Suturin-Daniil/Shchegly_SKAT26/Аэродинамика/Статистика/SpyLite.jpg

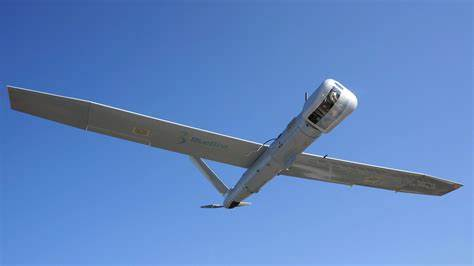
Аэродинамика/Статистика/SpyLite.jpg
