Suturin-Daniil/Shchegly_SKAT26/Аэродинамика/Статистика/Albatross.jpg

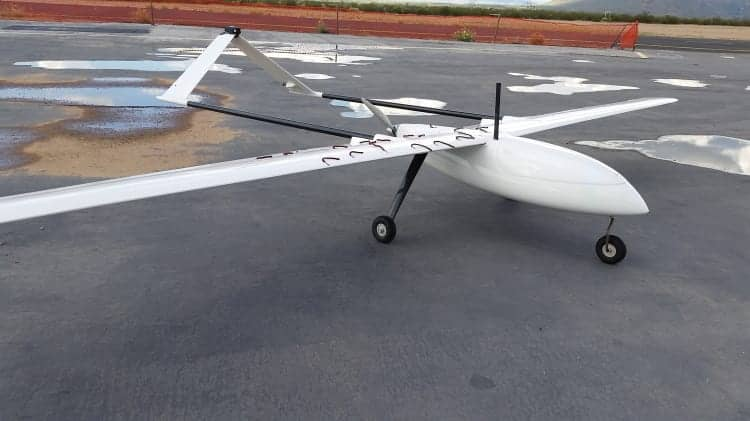
Аэродинамика/Статистика/Albatross.jpg
