Suturin-Daniil/Shchegly_SKAT26/БортовоеОборудование/USB_TTL.pdf

### USB to TTL, with embedded convertor

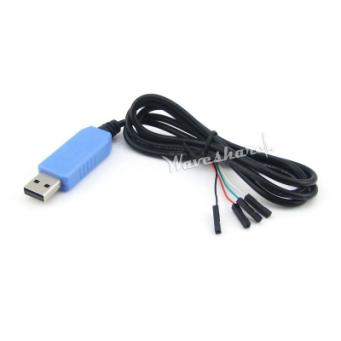
[picture p4: figure]

## Overview

USB to TTL 4-pin Wire specification:

- Embedded convertor: PL2303
- Supports Win8
- Connector: USB Type-A plug, 4-pin 2.54mm jumper wire connectors
- Jumper wire pinout:
- Red - VCC
- Black - GND
- Green - TXD
- White - RXD
- Length: 1m
