Suturin-Daniil/Shchegly_SKAT26/КомпьютерноеЗрение/dataset/readme.txt

Датасет из букв армянского алфавита.
200px — папка с исходными буквами размером 200х200.
Остальные размеры получаются путем ресайза с помощью python скрипта.
Все изображения следует сохранять в черно-белом варианте (8 бит на пиксель).
