Suturin-Daniil/Shchegly_SKAT26/Аэродинамика/ВыборПрофиля/ВыборПрофиляКрылаХвоста.docx

# 1 Облик ЛА

# Крыло и хвостовое оперений

В ходе анализа скоростного режима ЛА при выполнении полетного задания были определены воздушная скорость V_a = 18 м/с и диапазон чисел Рейнольдса, соответствующий скоростному режиму и геометрическим характеристикам БВС, Re≈(1÷5)⋅10^5 . Такой характер обтекания предполагает использования специализированных профилей, спроектированных для малых чисел Рейнольдса.

Первоначальную оценку коэффициент подъемной силы всего БВС C_(L_C) можно выполнить, зафиксировав вес снаряженного БВС W≈34,3 Н :

| C_(L_C) =(2L)/(ρV_a^2 S)= (2W)/(ρV_a^2 S) | (1)

Согласно статистике [2] C_(L_C) находится в диапазоне 0,4÷0,7. Выбирать целевой C_(L_C) следует на основе существующих профилей и геометрии крыла, обеспечивающих требуемый C_(L_C) . Завысим C_(L_C) – рискуем проиграть в общем сопротивлении БВС за счет индуцированного; занизим – рискуем получить крупное крыло, которое вносит существенный вклад в паразитное сопротивление. Для начальной оценки выберем C_(L_C) =0,45 , обоснование чего будет явным в последующих частях отчета. Таким образом, оценим согласно (1) требуемую площадь крыла S ; после подстановки получим S≈0,38 м^2 .

Сужение крыла λ зафиксируем равным 1 , прямое крыло. Удлинение AR=8 согласно статистическим данным из [3]. Угол установки крыла i_w был получен из оценки общего коэффициента подъемной силы БВС, который соответствует требуемому C_(L_C) при i_w =1° . Геометрические характеристики крыла представлены в таблице 1.

AR | λ | b, м | c, м | S, м^2 | i_w , °
8 | 1 | 1,74 | 0,22 | 0,38 | 1

Таблица 1 – Геометрические характеристики крыла

Выбор параметров хвостового оперения основан на методе объемных коэффициентов (2). Согласно данным из [3] и опыта команды объемные коэффициенты вертикального V_(VT) и горизонтального V_(HT) оперений выбраны равными 0,04 и 0,6 соответсвтенно.

| V_(HT) = (L_T S_(HT))/(cS), V_(VT) =(L_T S_(VT))/(bS), | (2)

где плечи горизонтального и вертикального оперения L_T (расстояние от аэродинамических центров хвостового оперения и крыла) выбраны равными, так как V-образный хвост. Согласно [4] площадь V-образного хвоста S_T есть сумма площадей вертикальной S_(VT) и горизонтальной S_(HT) составляющих, а угол V-образности Γ выражается следующим образом:

| S_T ≈S_(VT) +S_(HT) , Γ=arctan((S_(VT))/(S_(HT))) | (3)

Таким образом, геометрические характеристики одной консоли V-образного оперения представлены в таблице 2 ниже

AR_T | λ_T | b_T , м | c_T , м | S_T , м^2 | Γ,° | i_T , °
2 | 0,60 | 0,29 | 0,15 | 0,085 | 28 | 0,5

Таблица 2 – Геометрические характеристики хвостового оперения (одной консоли)

Угол установки хвостового оперения i_T был определен из требований продольной устойчивости, что будет показано в разделе продольная устойчивость.

# Управляющие поверхности

Размер управляющих поверхностей и доля размаха хвостового оперения и крыла, занимаемого ими, указаны в таблице 3.

| Элероны/Закрылки | Руль высоты
Доля хорды ( c_f /c ) | 0,3 | 0,3
Доля размаха ( b_f /b ) | 0,5 | 0,9

Таблица 3 – Геометрические характеристики управляющих поверхностейт имас

Выбор такой геометрии обусловлен тем, что предельная эффективность управляющих поверхностей (максимальный прирост ΔC_L за счет отклонения рулей) (рисунок 2) достигается при небольших углах отклонения рулей до 15°÷20° . Более того, как будет показано далее, такая конфигурация обеспечивает статическую устойчивость в продольном канале БВС.

# Аэродинамические профили

Исследуя материалы [1], был выбран ряд аэродинамических профилей для крыла, спроектированных для Проведен сравнительный анализ на основе критериев для различных этапов полета. Результат представлен ниже в таблице 1

Критерии | | | SD7032 | SD7037 | SG6041 | SG6043
Целевой C_(L_(max)) | | | 1,35
C_L для круиза | | | 0,48
Относительная толщина | | | 0,10 | 0,09 | 0,10 | 0,09
сваливание | Re | | 150'000
| C_l (0) (ближе к C_(L_c) – лучше) | | 0,44 | 0,37 | 0,24 | 0,51
| α_(ZL) , C_l (α_(ZL) )=0 | | -3,20° | -2,30° | -0,95° | -3,39°
| C_(l_(max)) | | 1,41 | 1,30 | 1,20 | 1,60
| α_s , C_l (α_s )=C_(l_(max)) | | 12,90° | 12,40° | 11,20° | 15,30°
| Характер сваливания | | Пологий | Крутой | Крутой | Крутой
круиз | Re | | 300'000
| C_(d_(min)) | | 0,0073 | 0,0070 | 0,0080 | 0,0093
| Чувствительность к качеству поверхности | | - | - | + | +
| C_l (C_(d_(min)) ) (ближе к C_(L_c) – лучше) | | 0,40 | 0,42 | 0,59 | 0,81
| ((C_l)/(C_d))_(max) | | 90 | 85 | 85 | 117
| C_l для ((C_l)/(C_d))_(max) (меньше – лучше) | | 0,98 | 0,85 | 0,69 | 1,20
| C_m для круиза (меньше |C_m | – лучше) | | -0,09 | -0,08 | -0,06 | -0,17
подъем | Re | | 200'000
| Laminar drag bucket | Начинается с C_l | 0,20 | 0,13 | -0,12 | 0,55
| | Кончается с C_l | 1,00 | 0,80 | 0,70 | 1,20
| C_(L_c) внутри | | + | + | + | -

Таблица 4 – Сравнительная характеристика профилей для крыла

1. Lyon, C.A., Broeren, A.P., Giguère, P., Gopalarathnam, A., and Selig, M.S., Summary of Low-Speed Airfoil Data, Vol. 3, SoarTech Publications, Virginia Beach, VA, 1998, 418 pages.
2. Gudmundsson S. General Aviation Aircraft Design: Applied Methods and Procedures / Butterworth-Heinemann, 2021.
3. Raymer D. P. Aircraft design: A Conceptual Approach / AIAA Inc., 2018.
4. NACA report No.823: "Experimental Verification of a Simplified Vee-Tail Theory and Analysis of Available Data on Complete Models with Vee-Tails" by Paul E. Purser and John P. Campbell, reprinted in an early SOARTECH
