Suturin-Daniil/Shchegly_SKAT26/БортовоеОборудование/X2814Размеры.pdf

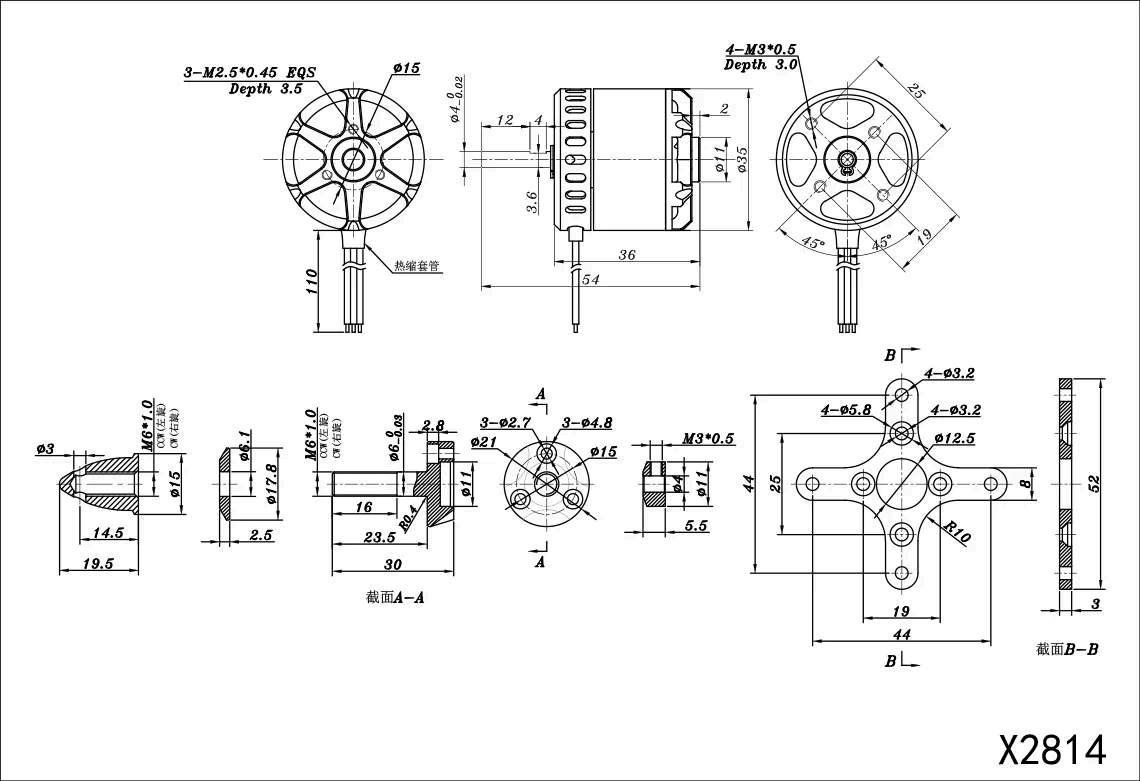
[picture p23: page 1]
