Suturin-Daniil/Shchegly_SKAT26/Аэродинамика/Code/LawOfEffectiveness.png

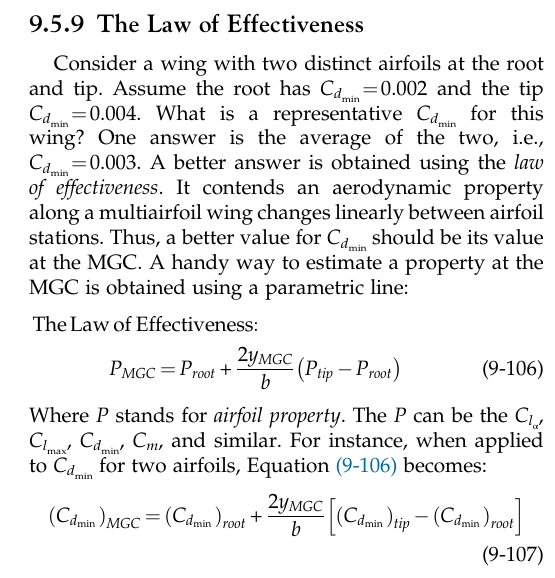
Аэродинамика/Code/LawOfEffectiveness.png
