Suturin-Daniil/Shchegly_SKAT26/Аэродинамика/Code/WingMaxLiftCoefficient.png

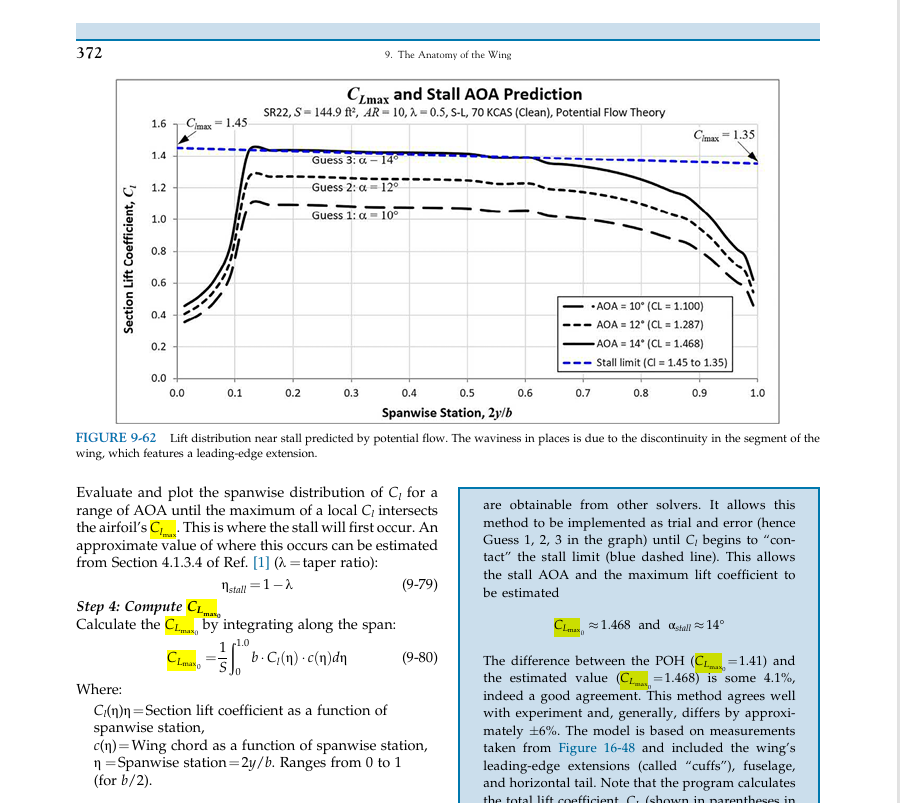
Аэродинамика/Code/WingMaxLiftCoefficient.png
