Suturin-Daniil/Shchegly_SKAT26/Аэродинамика/Code/WingZeroPitchingMomentCoeff.png

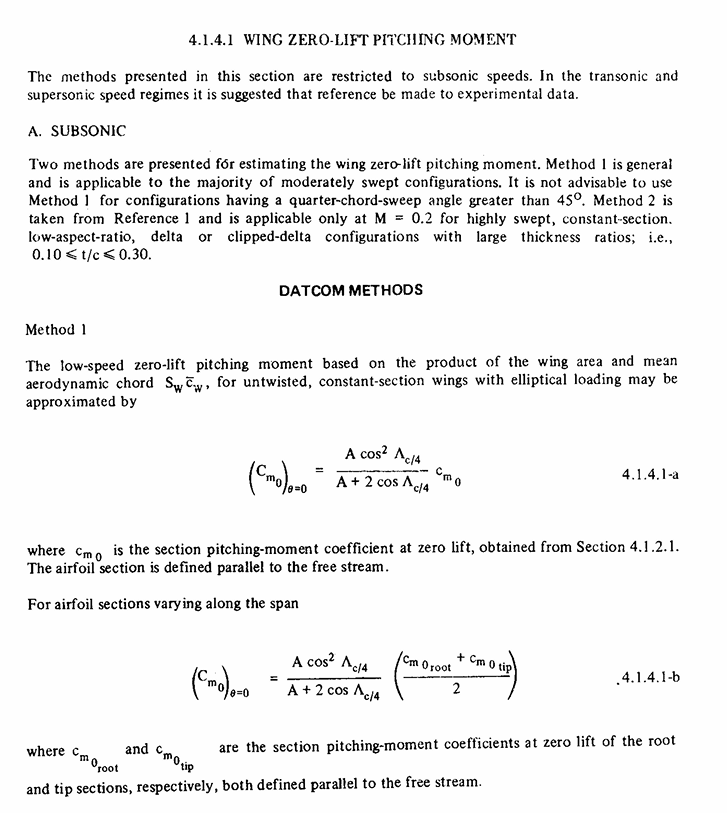
Аэродинамика/Code/WingZeroPitchingMomentCoeff.png
