Suturin-Daniil/Shchegly_SKAT26/Аэродинамика/Code/Конфигурация3/Init.jpg

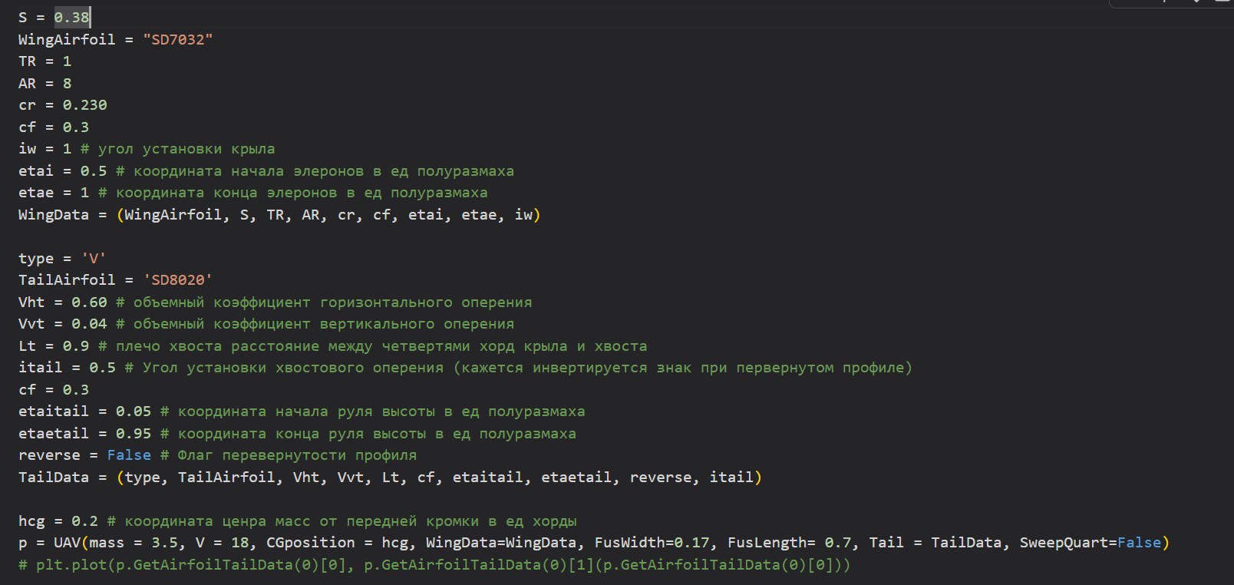
Аэродинамика/Code/Конфигурация3/Init.jpg
