Suturin-Daniil/Shchegly_SKAT26/Аэродинамика/Code/Конфигурация3/Param.jpg

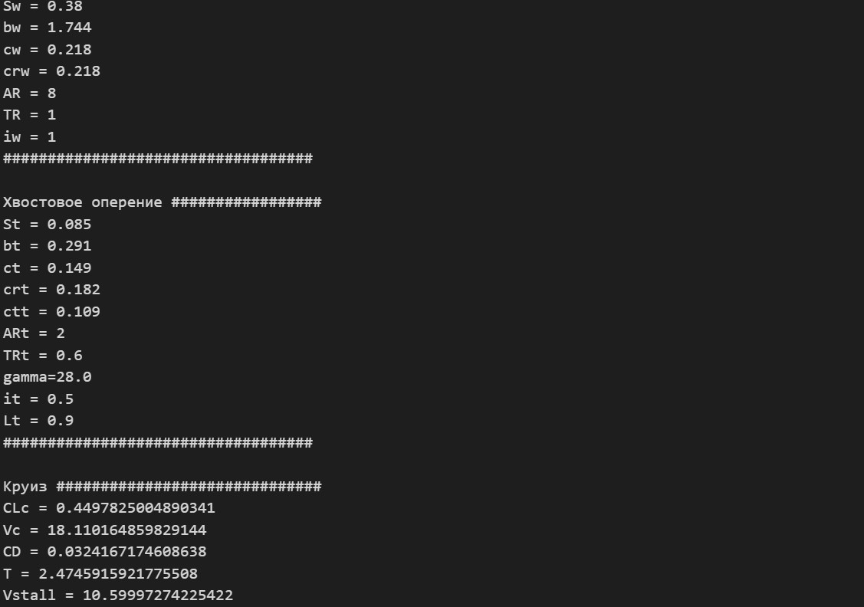
Аэродинамика/Code/Конфигурация3/Param.jpg
