Suturin-Daniil/Shchegly_SKAT26/Аэродинамика/Статистика/ALADIN.jpg

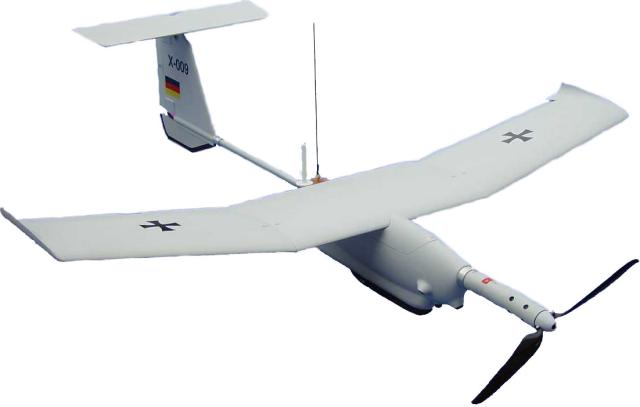
Аэродинамика/Статистика/ALADIN.jpg
