Suturin-Daniil/Shchegly_SKAT26/Аэродинамика/Статистика/Altius-600.png

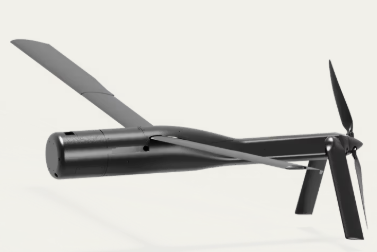
Аэродинамика/Статистика/Altius-600.png
