Suturin-Daniil/Shchegly_SKAT26/Аэродинамика/Статистика/AW5.jpg

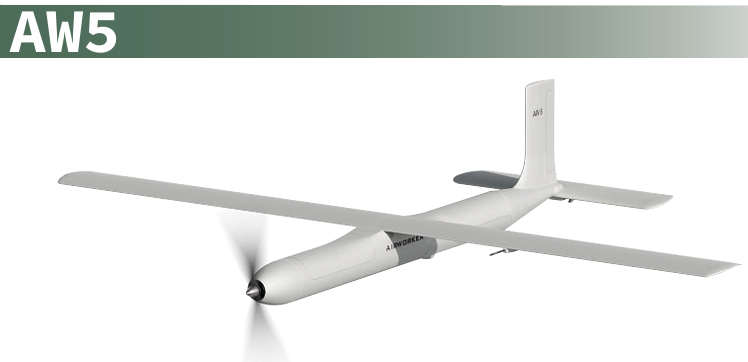
Аэродинамика/Статистика/AW5.jpg
