Suturin-Daniil/Shchegly_SKAT26/Аэродинамика/Статистика/AW6.png

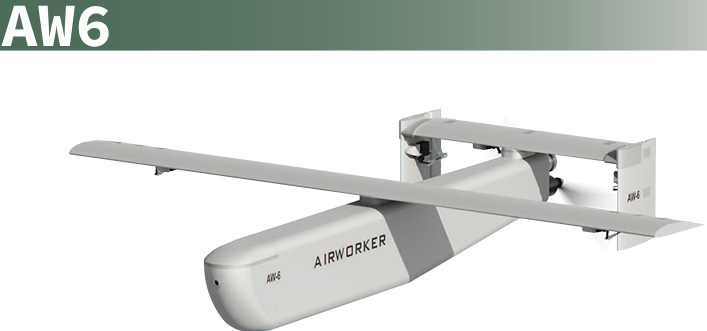
Аэродинамика/Статистика/AW6.png
