Suturin-Daniil/Shchegly_SKAT26/Аэродинамика/Статистика/AW15.png

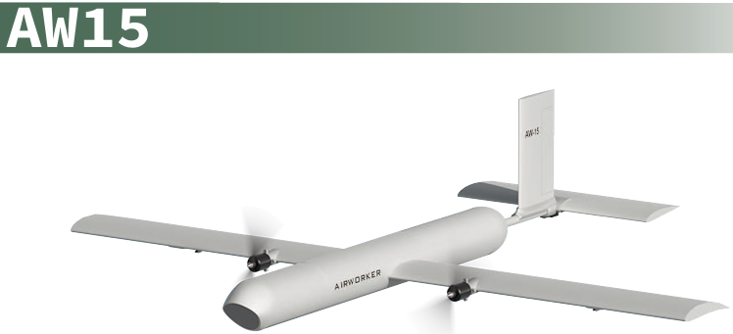
Аэродинамика/Статистика/AW15.png
