Suturin-Daniil/Shchegly_SKAT26/Аэродинамика/Статистика/Bayraktar.jpg

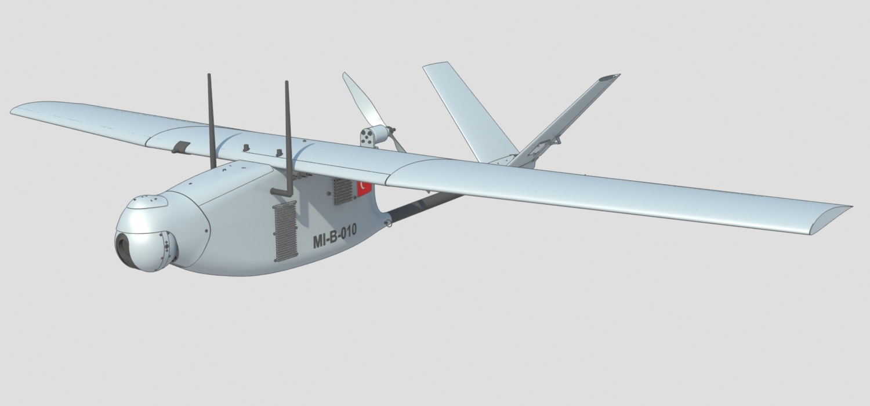
Аэродинамика/Статистика/Bayraktar.jpg
