Suturin-Daniil/Shchegly_SKAT26/Аэродинамика/Статистика/Black_Knight.png

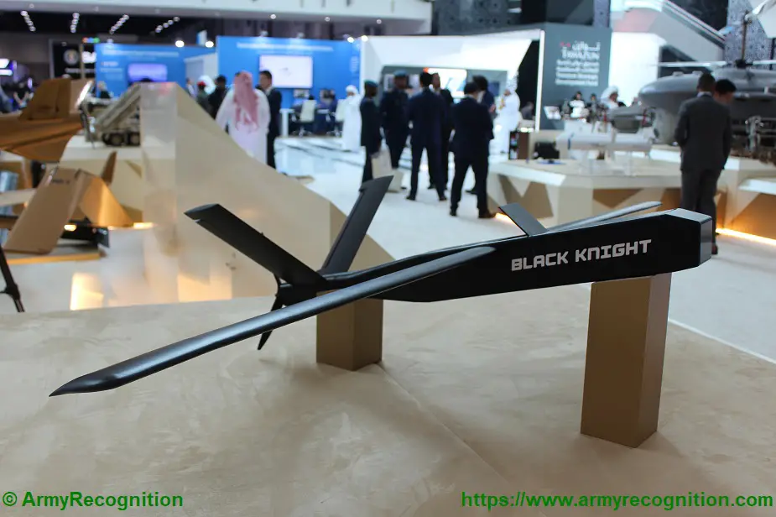
Аэродинамика/Статистика/Black_Knight.png
