Suturin-Daniil/Shchegly_SKAT26/Аэродинамика/Статистика/DesertHawk.jpg

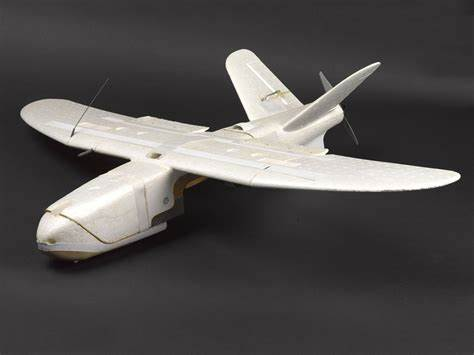
Аэродинамика/Статистика/DesertHawk.jpg
