Suturin-Daniil/Shchegly_SKAT26/Аэродинамика/Статистика/EOS.jpg

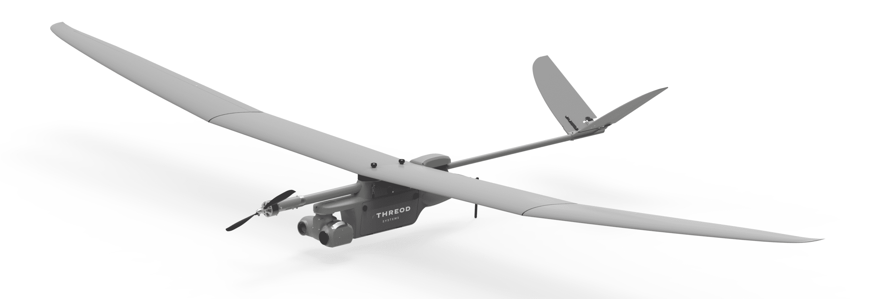
Аэродинамика/Статистика/EOS.jpg
