Suturin-Daniil/Shchegly_SKAT26/Аэродинамика/Статистика/Irkut3.jpg

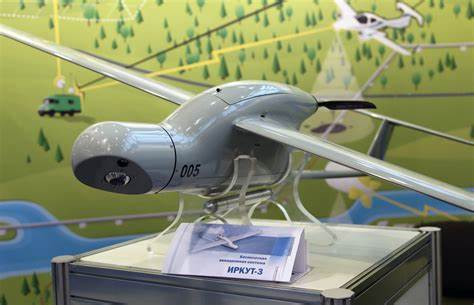
Аэродинамика/Статистика/Irkut3.jpg
