Suturin-Daniil/Shchegly_SKAT26/Аэродинамика/Статистика/Pointer.jpg

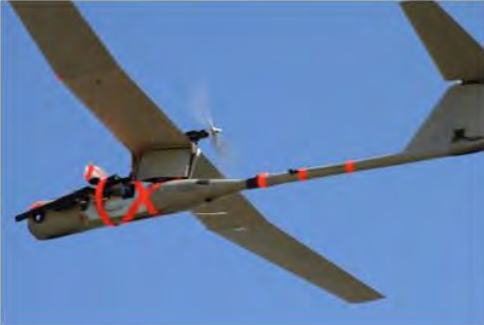
Аэродинамика/Статистика/Pointer.jpg
