Suturin-Daniil/Shchegly_SKAT26/Аэродинамика/Статистика/Raven.jpg

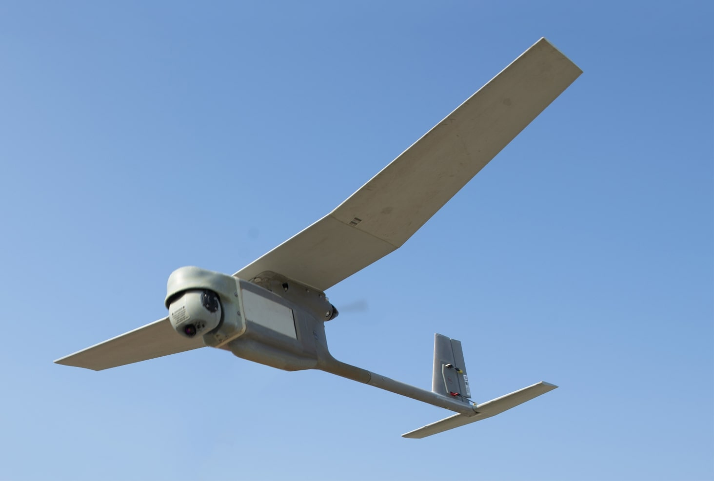
Аэродинамика/Статистика/Raven.jpg
