Suturin-Daniil/Shchegly_SKAT26/Аэродинамика/Статистика/Rover MK1.jpg

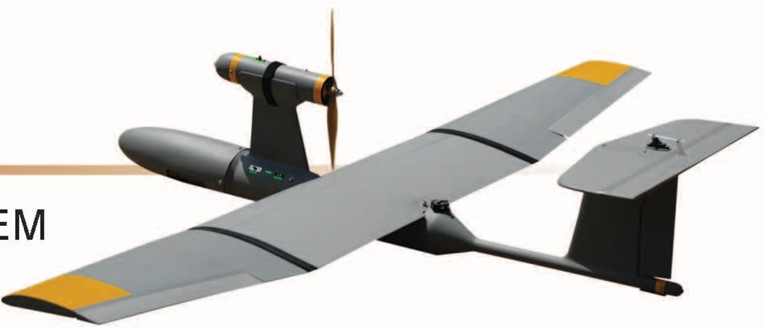
Аэродинамика/Статистика/Rover MK1.jpg
