Suturin-Daniil/Shchegly_SKAT26/Аэродинамика/Статистика/Statistics_Horiz.png

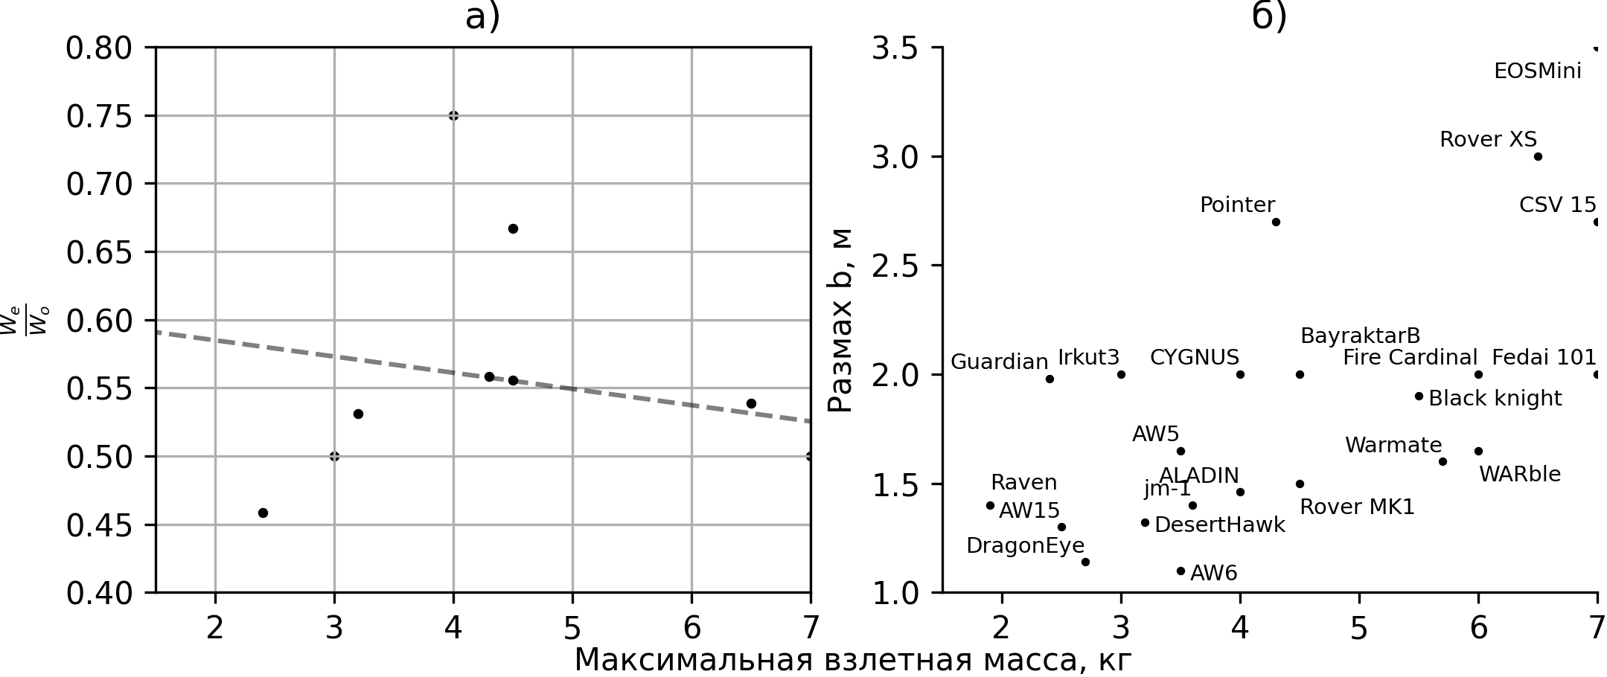
Аэродинамика/Статистика/Statistics_Horiz.png
