Suturin-Daniil/Shchegly_SKAT26/Аэродинамика/Статистика/Statistics_Vert.png

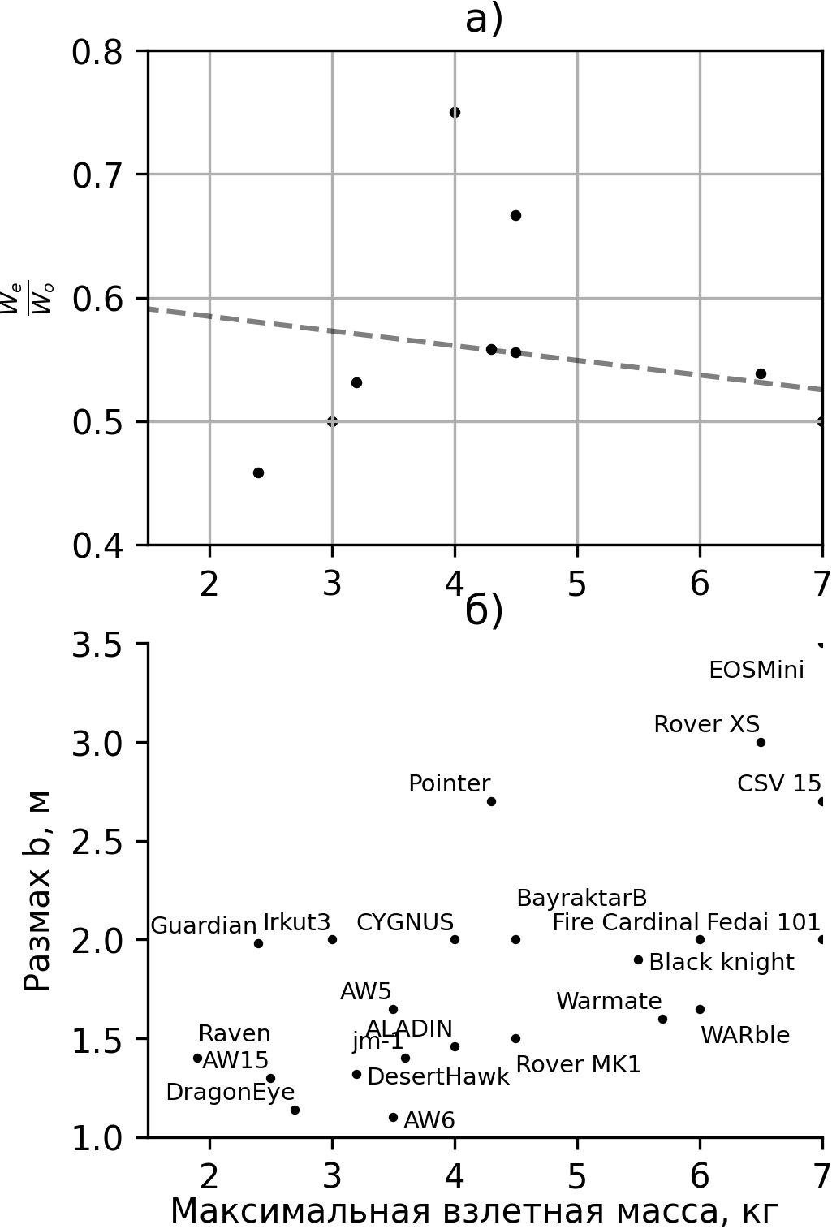
Аэродинамика/Статистика/Statistics_Vert.png
