Suturin-Daniil/Shchegly_SKAT26/Аэродинамика/Статистика/UAVs.png

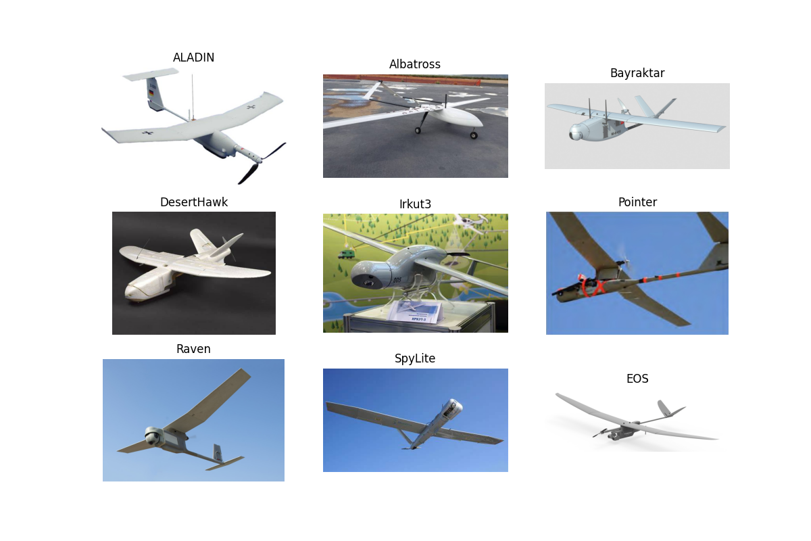
Аэродинамика/Статистика/UAVs.png
