Suturin-Daniil/Shchegly_SKAT26/Документы/_Отчеты/Проектный/Радиус виража.png

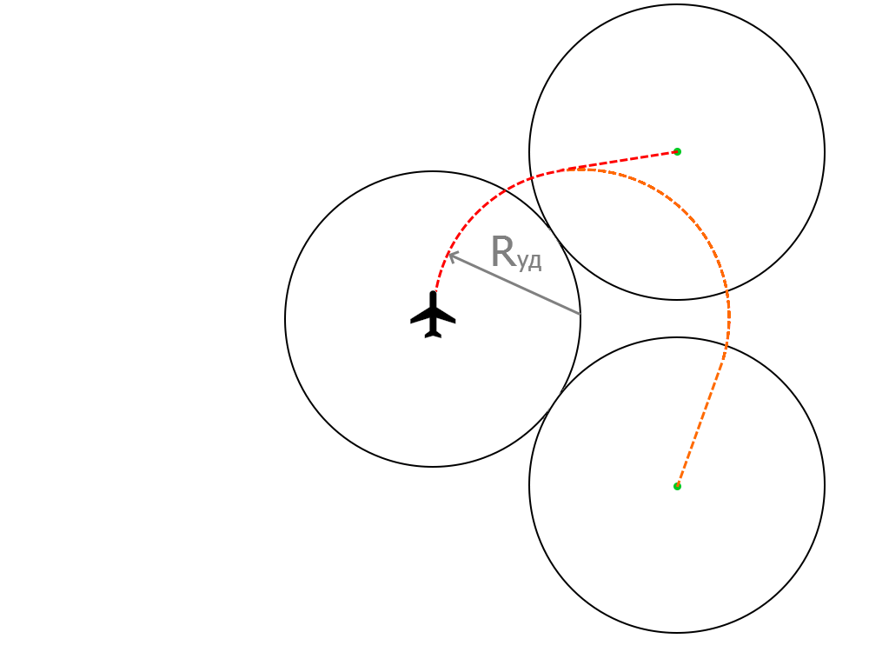
Документы/_Отчеты/Проектный/Радиус виража.png
