Suturin-Daniil/Shchegly_SKAT26/КомпьютерноеЗрение/dataset/200px/letter_2.png

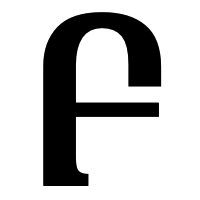
КомпьютерноеЗрение/dataset/200px/letter_2.png
