Suturin-Daniil/Shchegly_SKAT26/КомпьютерноеЗрение/dataset/200px/letter_17.png

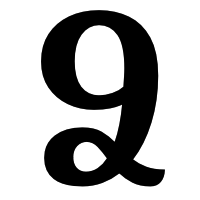
КомпьютерноеЗрение/dataset/200px/letter_17.png
