Suturin-Daniil/Shchegly_SKAT26/КомпьютерноеЗрение/dataset/200px/letter_25.png

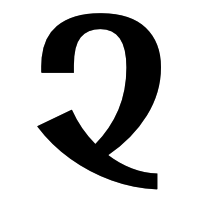
КомпьютерноеЗрение/dataset/200px/letter_25.png
