Suturin-Daniil/Shchegly_SKAT26/КомпьютерноеЗрение/dataset/200px/letter_29.png

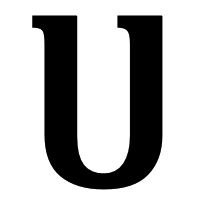
КомпьютерноеЗрение/dataset/200px/letter_29.png
