Suturin-Daniil/Shchegly_SKAT26/Модель/Полетник/H743-WING_2.jpg

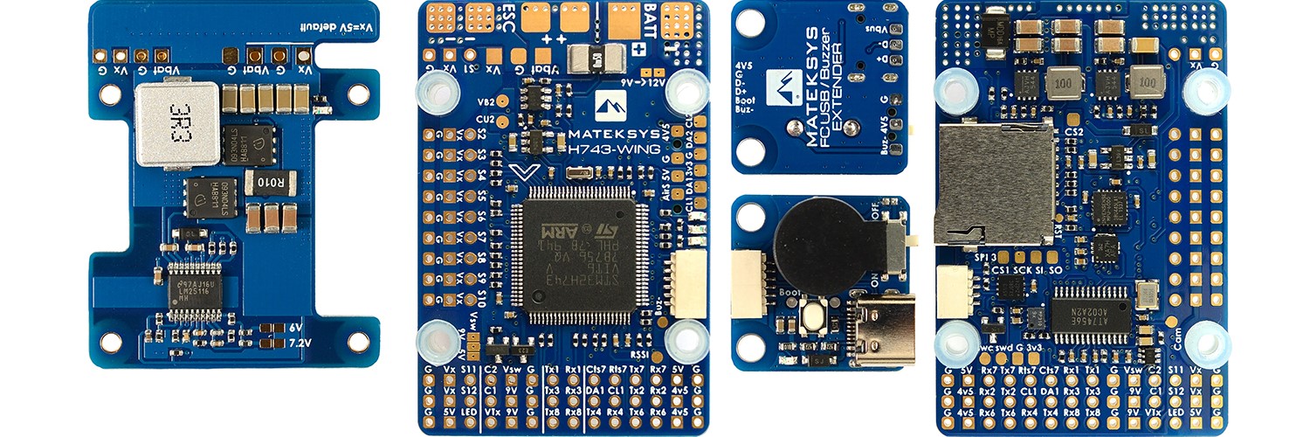
Модель/Полетник/H743-WING_2.jpg
