Suturin-Daniil/Shchegly_SKAT26/Смета/MotorAndESC.png

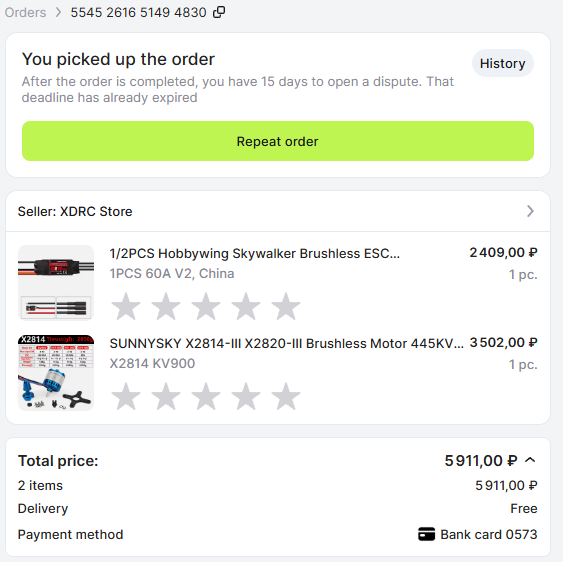
Смета/MotorAndESC.png
