Suturin-Daniil/Shchegly_SKAT26/Смета/Смета.xlsx

№ | Наименование | Количество, шт | Цена, руб | Магазин | Стоимость, руб
1 | Переходник SMA-female - MMCX угловой пигтейл длина 10 см | 1 | 383.03 | ozon (https://www.ozon.ru/product/perehodnik-sma-female-mmcx-uglovoy-pigteyl-dlina-10-sm-3523967441/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) | 383.03
2 | FPV камера для квадрокоптера CADDXFPV Ratel Pro 1500TVL | 1 | 5847 | ozon (https://www.ozon.ru/product/fpv-kamera-dlya-kvadrokoptera-caddxfpv-ratel-pro-1500tvl-1672089772/) | 5847
3 | Специальный мешок для зарядки и хранения LiPol аккумуляторов Deep RC 23x30 см | 1 | 615 | ozon (https://www.ozon.ru/product/spetsialnyy-meshok-dlya-zaryadki-i-hraneniya-lipol-akkumulyatorov-deep-rc-23x30-sm-203490556/) | 615
4 | Разъем прямой MMCX TO SMA Female | 1 | 426.00 | ozon (https://www.ozon.ru/product/razem-pryamoy-mmcx-to-sma-female-1416162178/) | 426
5 | Переключаемый VTX модуль видеопередатчика с OSD для FPV дрона, JHEMCU VTX30-800 VTX5848 LITE 40CH 5,8G 25/100/200/400 МВт | 1 | 4296.04 | ozon (https://www.ozon.ru/product/pereklyuchaemyy-vtx-modul-videoperedatchika-s-osd-dlya-fpv-drona-jhemcu-vtx30-800-vtx5848-lite-1233070584/) | 4296.04
6 | Антенна Foxeer Pagoda Pro 5,8 GHz RHCP 86 mm SMA для FPV дронов квадрокоптеров самолетов | 1 | 1288.00 | ozon (https://www.ozon.ru/product/antenna-foxeer-pagoda-pro-5-8-ghz-rhcp-86-mm-sma-dlya-fpv-dronov-kvadrokopterov-samoletov-2892157317/) | 1288
7 | Складной пропеллер 1180 11 x 8 дюймов Haoye для авиамоделей из пластика | 1 | 1476.00 | ozon (https://www.ozon.ru/product/skladnoy-propeller-1180-11-x-8-dyuymov-haoye-dlya-aviamodeley-iz-plastika-1480374542/) | 1476
8 | Замок-защелка с пружиной W-528 (10 шт в наборе) Никель , замок накидной | 1 | 556.00 | ozon (https://www.ozon.ru/product/zamok-zashchelka-s-pruzhinoy-w-528-10-sht-v-nabore-nikel-zamok-nakidnoy-282740863/) | 556
9 | Мотор SunnySky X2814 900kv | 1 | 3500.00 | aliexpress (https://aliexpress.ru/store/4813005?g=true&page=1&spm=a2g2w.orderdetail.0.0.207f4aa6r8cpUO) | 3500
10 | Регулятор оборотов бесколекторного двигателя HobbyWing 60A | 1 | 2409.00 | aliexpress (https://aliexpress.ru/store/4813005?g=true&page=1&spm=a2g2w.orderdetail.0.0.207f4aa6r8cpUO) | 2409
11 | OpenMV Cam H7 Plus | 1 | 7040.00 | ozon (https://www.ozon.ru/product/openmv-cam-h7-plus-singtown-5mp-kamera-raspoznavaniya-izobrazheniy-s-vysokim-razresheniem-2560037641/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) | 7040
12
13
