Suturin-Daniil/Shchegly_SKAT26/Модель/Аккумуляторы/2p4s18650.SLDASM

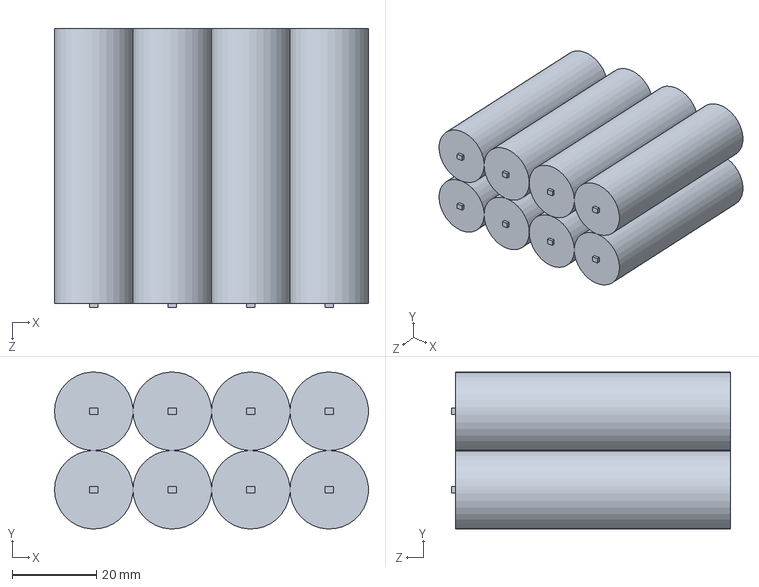
[picture p80: CAD file, 2026-04-19]
Модель/Аккумуляторы/2p4s18650.SLDASM
74.4 x 37.2 x 66.2 mm
Аккумулятор18650 x 8
