Suturin-Daniil/Shchegly_SKAT26/Модель/payload.step

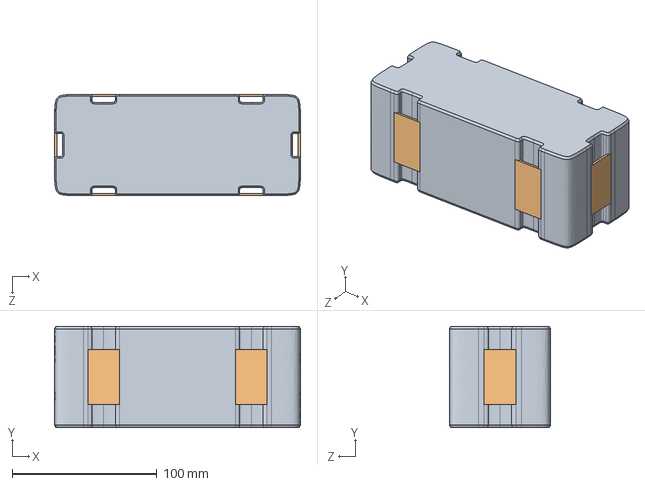
[picture p81: CAD file, 2026-05-01]
Модель/payload.step
170.0 x 70.0 x 70.0 mm
