Suturin-Daniil/Shchegly_SKAT26/Модель/Камера/CaddxRatelPRO.step

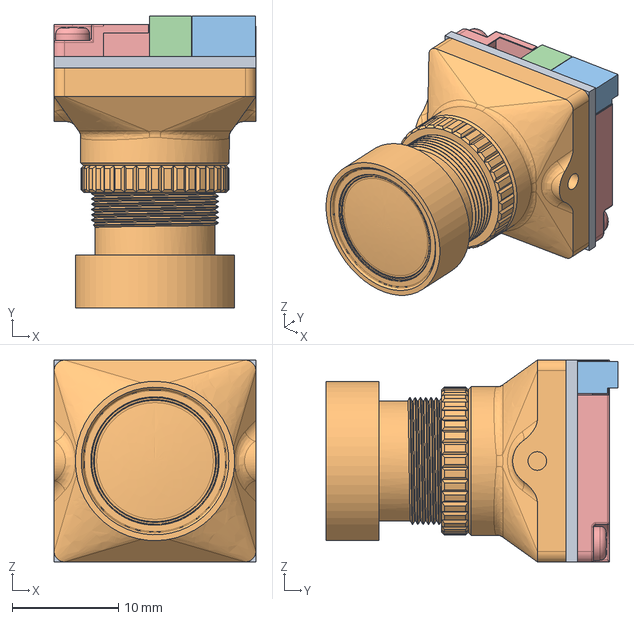
[picture p82: CAD file, 2026-04-19]
Модель/Камера/CaddxRatelPRO.step
19.0 x 27.5 x 19.0 mm
