Suturin-Daniil/Shchegly_SKAT26/Модель/МодулиБРЭО/ВидеоПередатчик.SLDPRT

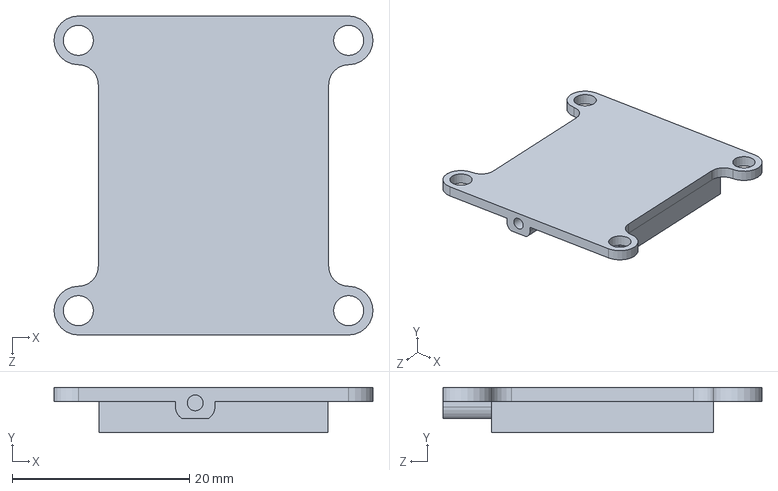
[picture p83: CAD file, 2026-04-28]
Модель/МодулиБРЭО/ВидеоПередатчик.SLDPRT
36.0 x 5.10 x 36.0 mm
