Suturin-Daniil/Shchegly_SKAT26/Модель/Аккумуляторы/Аккумулятор18650.SLDPRT

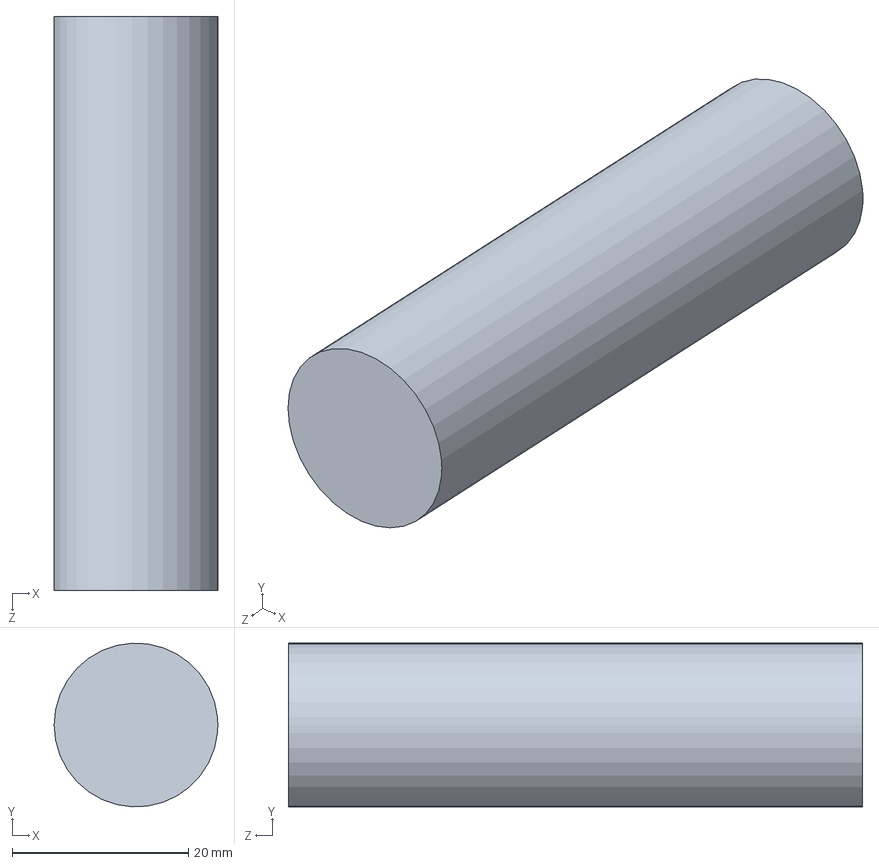
[picture p84: CAD file, 2026-04-19]
Модель/Аккумуляторы/Аккумулятор18650.SLDPRT
18.6 x 18.6 x 65.2 mm
