Suturin-Daniil/Shchegly_SKAT26/Модель/Крючок.SLDPRT

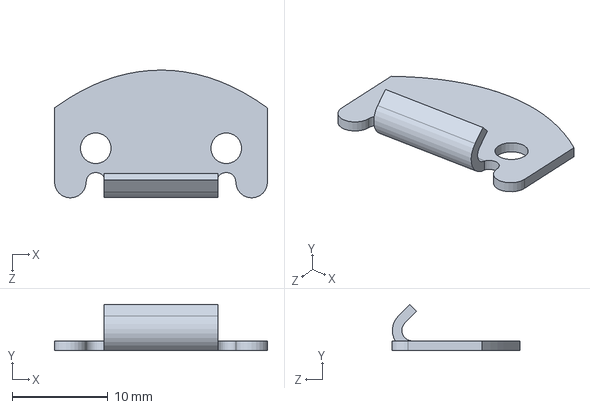
[picture p86: CAD file, 2026-04-19]
Модель/Крючок.SLDPRT
22.2 x 4.81 x 13.3 mm
