Suturin-Daniil/Shchegly_SKAT26/Модель/МодулиБРЭО/GNSS Matek M10q 5883.stp.SLDPRT

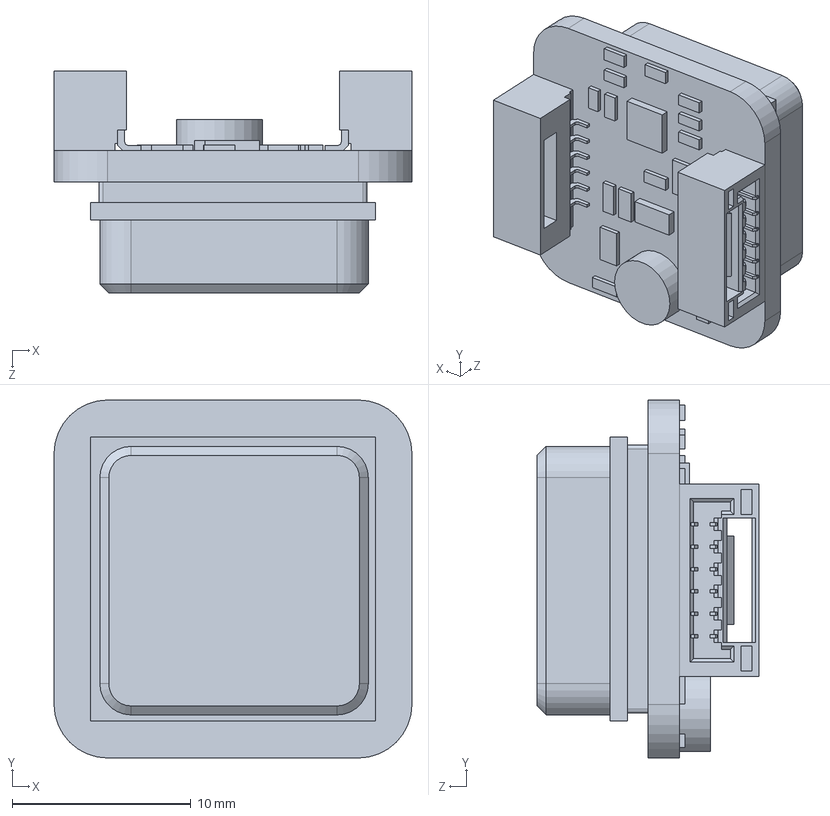
[picture p87: CAD file, 2026-04-19]
Модель/МодулиБРЭО/GNSS Matek M10q 5883.stp.SLDPRT
20.0 x 20.0 x 12.4 mm
