Suturin-Daniil/Shchegly_SKAT26/Модель/Полетник/FCBoard3.SLDPRT

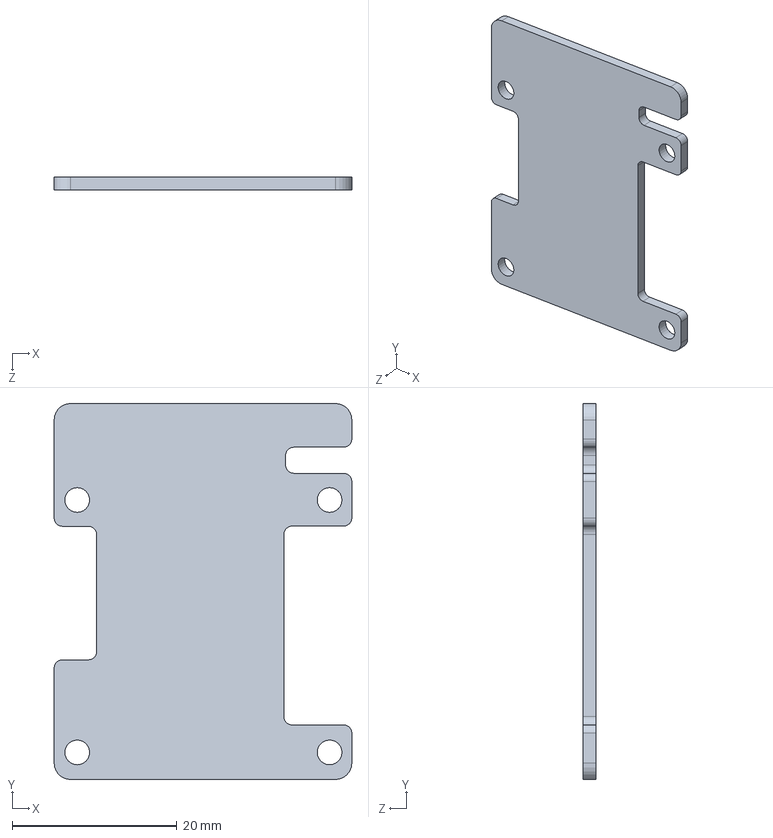
[picture p88: CAD file, 2026-04-17]
Модель/Полетник/FCBoard3.SLDPRT
36.1 x 45.6 x 1.60 mm
