Suturin-Daniil/Shchegly_SKAT26/Модель/Защелка.SLDPRT

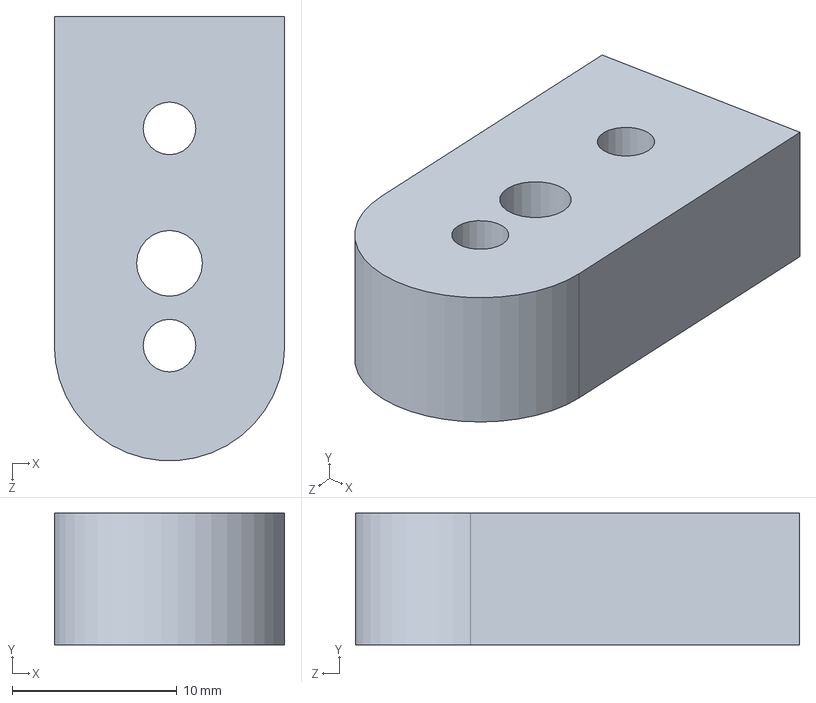
[picture p89: CAD file, 2026-04-19]
Модель/Защелка.SLDPRT
14.0 x 8.00 x 27.0 mm
