Suturin-Daniil/Shchegly_SKAT26/Модель/Полетник/FCBoard2.SLDPRT

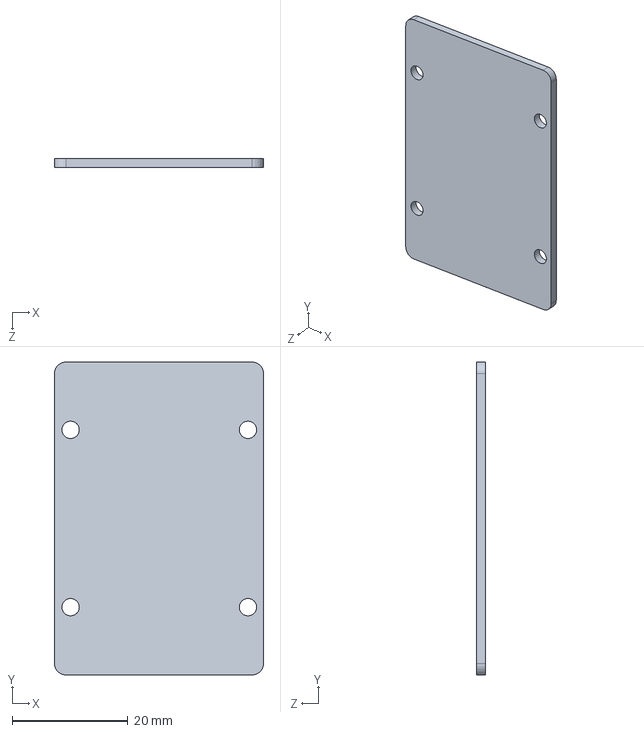
[picture p90: CAD file, 2026-04-17]
Модель/Полетник/FCBoard2.SLDPRT
36.1 x 54.0 x 1.60 mm
