Suturin-Daniil/Shchegly_SKAT26/Модель/МодулиБРЭО/ASPD-4525.step

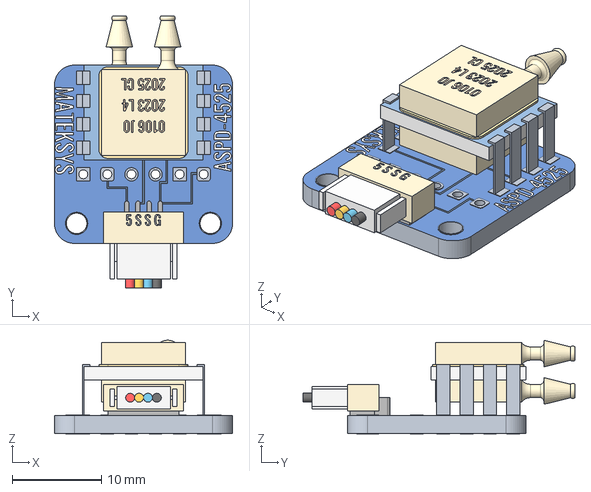
[picture p91: CAD file, 2026-04-17]
Модель/МодулиБРЭО/ASPD-4525.step
20.0 x 30.5 x 10.5 mm
