Suturin-Daniil/Shchegly_SKAT26/Модель/X2814.SLDPRT

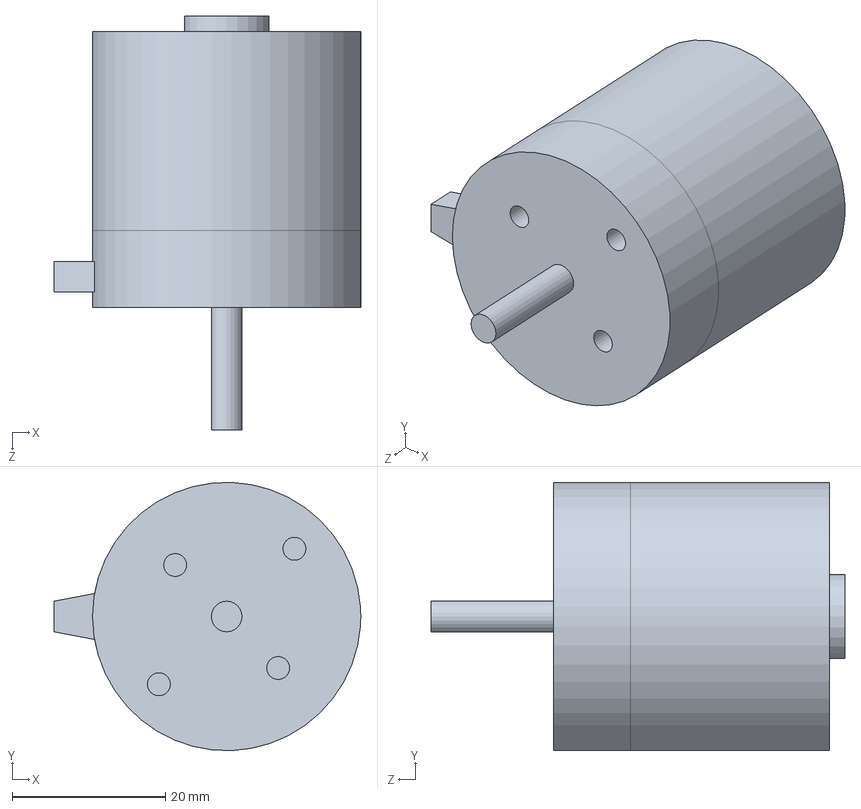
[picture p92: CAD file, 2026-04-03]
Модель/X2814.SLDPRT
40.0 x 35.0 x 54.0 mm
