Suturin-Daniil/Shchegly_SKAT26/Модель/МодулиБРЭО/TelemetryModule.STEP

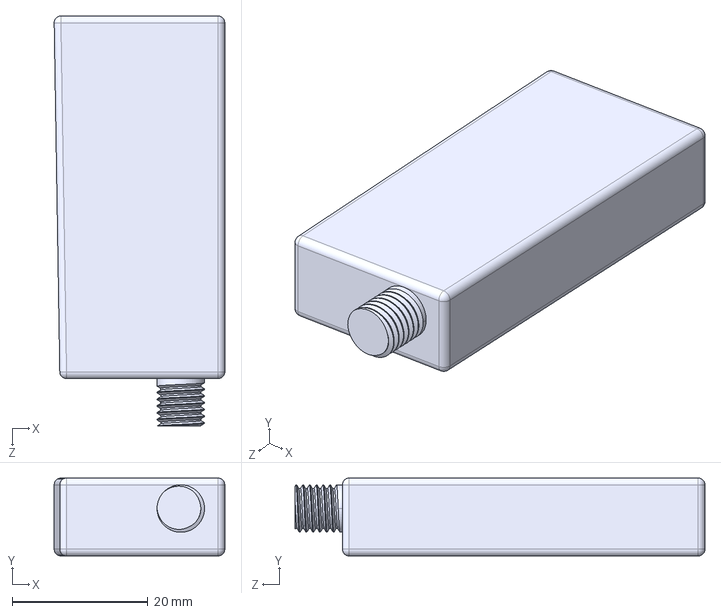
[picture p93: CAD file, 2026-04-14]
Модель/МодулиБРЭО/TelemetryModule.STEP
25.2 x 11.5 x 60.5 mm
