Suturin-Daniil/Shchegly_SKAT26/Модель/Полетник/PCBHolder.SLDPRT

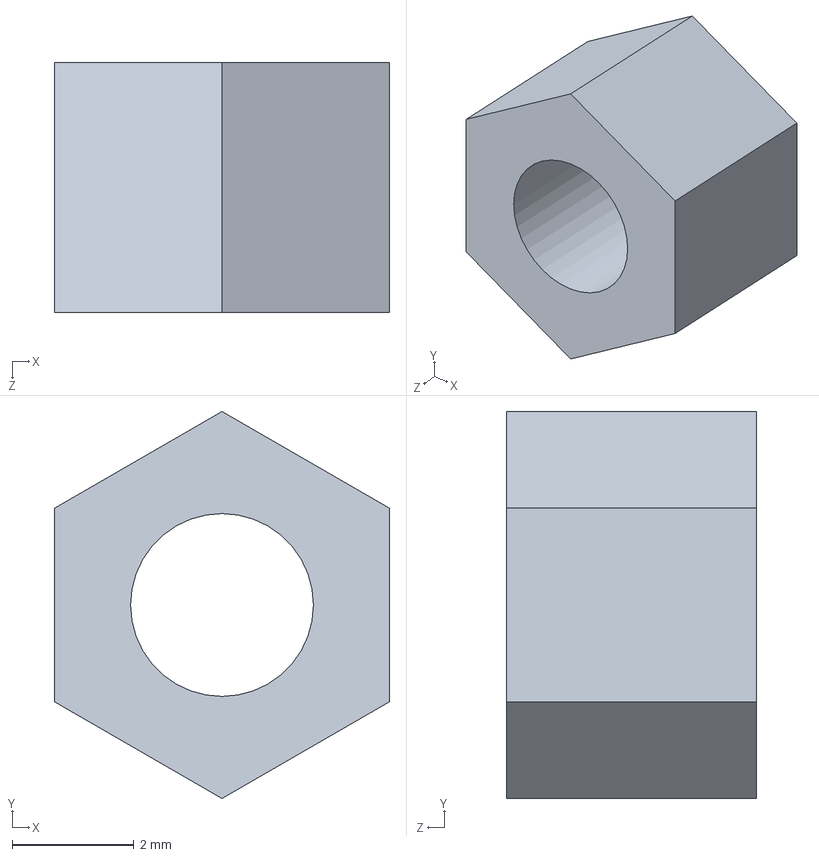
[picture p94: CAD file, 2026-04-17]
Модель/Полетник/PCBHolder.SLDPRT
5.50 x 6.35 x 4.10 mm
