Suturin-Daniil/Shchegly_SKAT26/Модель/Horn.SLDPRT

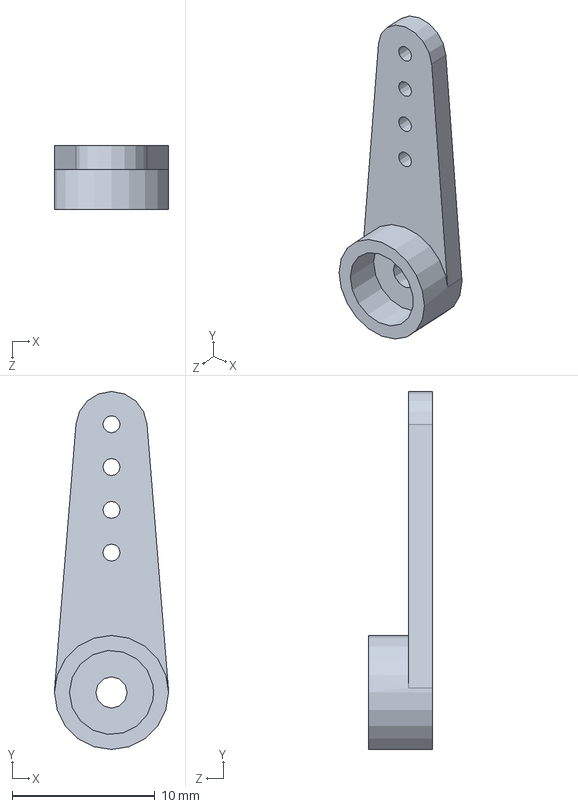
[picture p95: CAD file, 2026-03-10]
Модель/Horn.SLDPRT
8.00 x 25.1 x 4.50 mm
