Suturin-Daniil/Shchegly_SKAT26/Модель/МодулиБРЭО/Tracker.SLDPRT

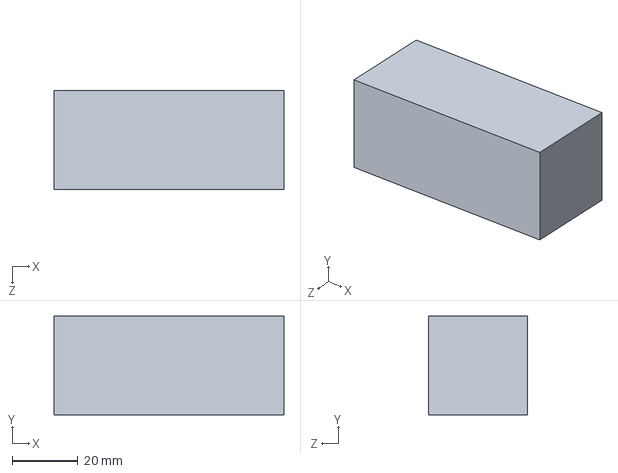
[picture p96: CAD file, 2026-04-03]
Модель/МодулиБРЭО/Tracker.SLDPRT
70.0 x 30.0 x 30.0 mm
