Suturin-Daniil/Shchegly_SKAT26/Модель/Полетник/ПолетныйКонтроллер.STEP

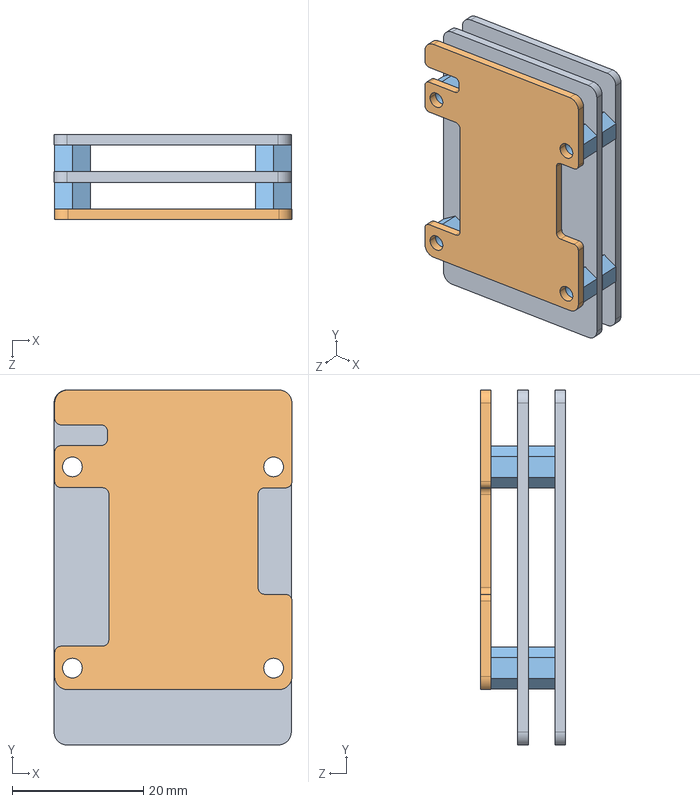
[picture p97: CAD file, 2026-04-17]
Модель/Полетник/ПолетныйКонтроллер.STEP
36.2 x 54.0 x 13.0 mm
FCBoard1.STEP
FCBoard2.STEP
FCBoard3.STEP
PCBHolder.STEP x 8
