Suturin-Daniil/Shchegly_SKAT26/Модель/ESC.SLDPRT

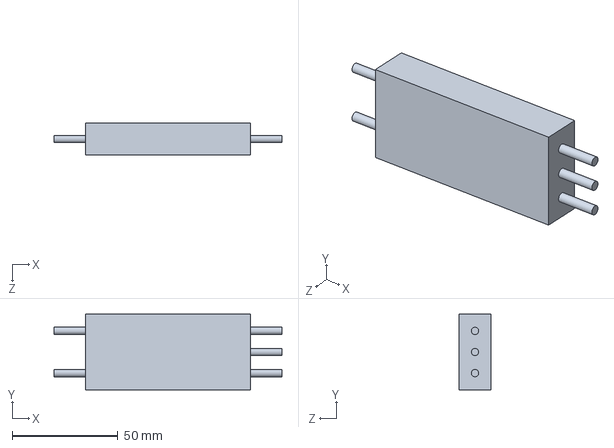
[picture p98: CAD file, 2026-03-10]
Модель/ESC.SLDPRT
108.0 x 36.0 x 15.0 mm
