Suturin-Daniil/Shchegly_SKAT26/Модель/JXServo.SLDPRT

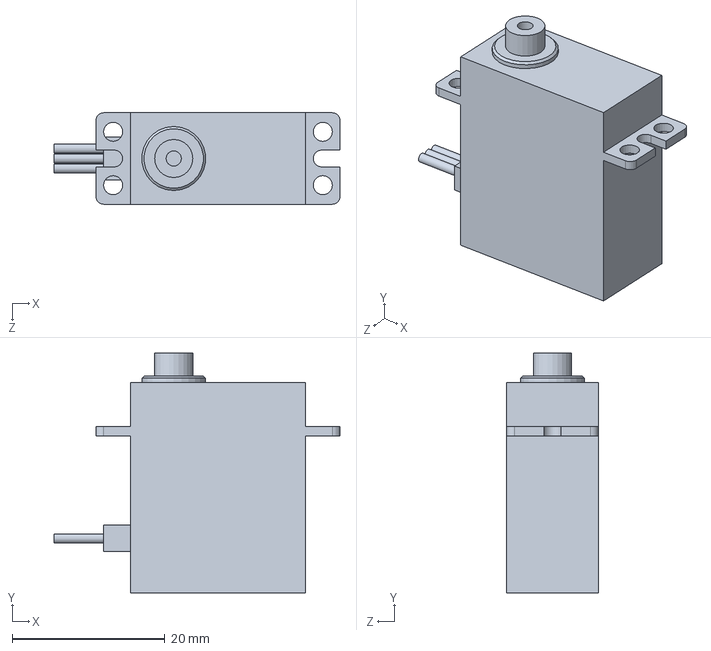
[picture p99: CAD file, 2026-03-10]
Модель/JXServo.SLDPRT
37.5 x 31.5 x 12.0 mm
