Suturin-Daniil/Shchegly_SKAT26/(list of files, cad)

Other CAD files:
Модель/Полетник/FCSketch.SLDPRT
Модель/МодулиБРЭО/GNSS Matek M10q 5883.stp
Модель/Fuselage.SLDPRT
Модель/Полетник/FCBoard1.SLDPRT
Документы/_Отчеты/Концептуальный отчет/Эскиз.SLDDRW
Модель/МодулиБРЭО/ASPD-4525.SLDPRT
Модель/Полетник/ПолетныйКонтроллер.SLDASM
