Suturin-Daniil/Shchegly_SKAT26/ГрафикРабот.pdf

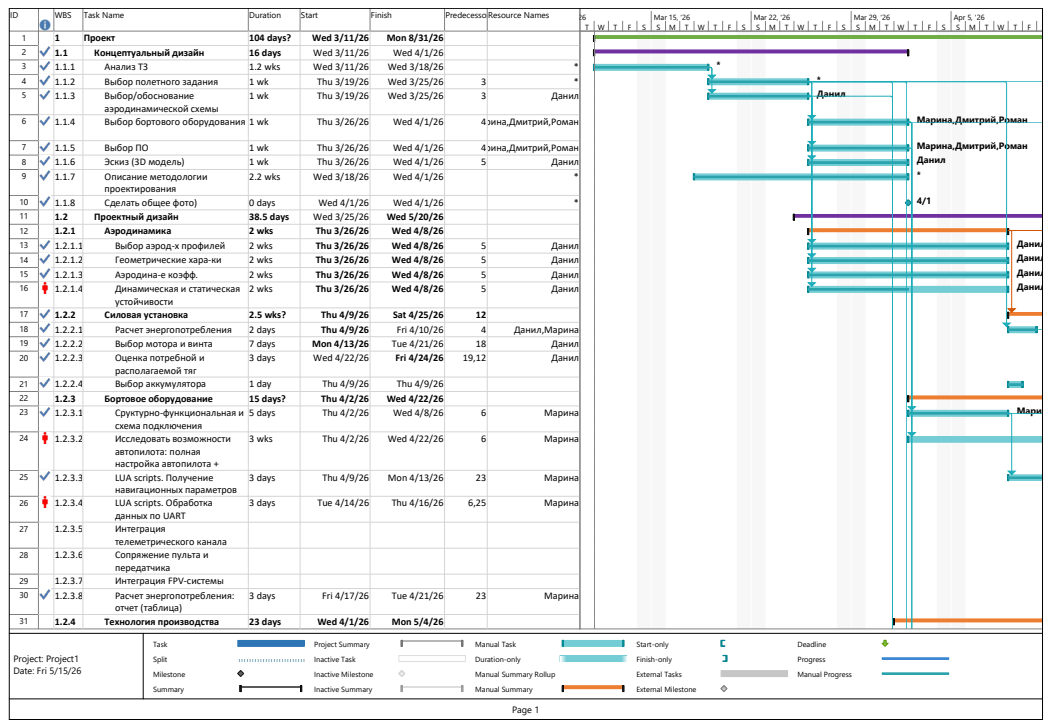
[picture p100: page 1]
* Данил; Марина,Дмитрий,Роман Данил *; Данил Данил Данил Данил; Марина; Mar 15, '26; Mar 22, '26; Mar 29, '26; Apr 5, '26; Task; Split; Milestone; Summary; Project Summary; Inactive Task; Inactive Milestone; Inactive Summary; Start-only; Finish-only; External Tasks; External Milestone; Deadline; Progress; Manual Progress; Page 1; Project: Project1 Date: Fri 5/15/26

ID | WBS | Task Name | Duration | Start | Finish | PredecessorsResource Names
1 | 1 | Проект | 104 days? | Wed 3/11/26 | Mon 8/31/26
2 | 1.1 | Концептуальный дизайн | 16 days | Wed 3/11/26 | Wed 4/1/26
3 | 1.1.1 | Анализ ТЗ | 1.2 wks | Wed 3/11/26 | Wed 3/18/26 | | *
4 | 1.1.2 | Выбор полетного задания | 1 wk | Thu 3/19/26 | Wed 3/25/26 | 3 | *
5 | 1.1.3 | Выбор/обоснование аэродинамической схемы | 1 wk | Thu 3/19/26 | Wed 3/25/26 | 3 | Данил

6 | 1.1.4 | Выбор бортового оборудования 1 wk | | Thu 3/26/26 | Wed 4/1/26 | Марина,Дмитрий,Роман 4

Марина,Дмитрий,Роман

7 | 1.1.5 | Выбор ПО | 1 wk | Thu 3/26/26 | Wed 4/1/26 | Марина,Дмитрий,Роман 4
8 | 1.1.6 | Эскиз (3D модель) | 1 wk | Thu 3/26/26 | Wed 4/1/26 | 5 | Данил
9 | 1.1.7 | Описание методологии проектирования | 2.2 wks | Wed 3/18/26 | Wed 4/1/26 | | *

10 | 1.1.8 | Сделать общее фото) | 0 days | Wed 4/1/26 | Wed 4/1/26 | | *
11 | 1.2 | Проектный дизайн | 38.5 days | Wed 3/25/26 | Wed 5/20/26
12 | 1.2.1 | Аэродинамика | 2 wks | Thu 3/26/26 | Wed 4/8/26
13 | 1.2.1.1 | Выбор аэрод-х профилей | 2 wks | Thu 3/26/26 | Wed 4/8/26 | 5 | Данил
14 | 1.2.1.2 | Геометрические хара-ки | 2 wks | Thu 3/26/26 | Wed 4/8/26 | 5 | Данил
15 | 1.2.1.3 | Аэродина-е коэфф. | 2 wks | Thu 3/26/26 | Wed 4/8/26 | 5 | Данил
16 | 1.2.1.4 | Динамическая и статическая устойчивости | 2 wks | Thu 3/26/26 | Wed 4/8/26 | 5 | Данил

17 | 1.2.2 | Силовая установка | 2.5 wks? | Thu 4/9/26 | Sat 4/25/26 | 12
18 | 1.2.2.1 | Расчет энергопотребления | 2 days | Thu 4/9/26 | Fri 4/10/26 | 4 | Данил,Марина
19 | 1.2.2.2 | Выбор мотора и винта | 7 days | Mon 4/13/26 | Tue 4/21/26 | 18 | Данил
20 | 1.2.2.3 | Оценка потребной и располагаемой тяг | 3 days | Wed 4/22/26 | Fri 4/24/26 | 19,12 | Данил

21 | 1.2.2.4 | Выбор аккумулятора | 1 day | Thu 4/9/26 | Thu 4/9/26
22 | 1.2.3 | Бортовое оборудование | 15 days? | Thu 4/2/26 | Wed 4/22/26
23 | 1.2.3.1 | Сруктурно-функциональная и схема подключения | 5 days | Thu 4/2/26 | Wed 4/8/26 | 6 | Марина

24 | 1.2.3.2 | Исследовать возможности автопилота: полная настройка автопилота + | 3 wks | Thu 4/2/26 | Wed 4/22/26 | 6 | Марина

25 | 1.2.3.3 | LUA scripts. Получение навигационных параметров | 3 days | Thu 4/9/26 | Mon 4/13/26 | 23 | Марина

26 | 1.2.3.4 | LUA scripts. Обработка данных по UART | 3 days | Tue 4/14/26 | Thu 4/16/26 | 6,25 | Марина

27 | 1.2.3.5 | Интеграция телеметрического канала

28 | 1.2.3.6 | Сопряжение пульта и передатчика

29 | 1.2.3.7 | Интеграция FPV-системы
30 | 1.2.3.8 | Расчет энергопотребления: отчет (таблица) | 3 days | Fri 4/17/26 | Tue 4/21/26 | 23 | Марина

31 | 1.2.4 | Технология производства | 23 days | Wed 4/1/26 | Mon 5/4/26

Manual Task
Duration-only
Manual Summary Rollup
Manual Summary

ID | WBS | Task Name | Duration | Start | Finish | PredecessorsResource Names
32 | 1.2.4.1 | Выбор материалов конструкции5 days | | Wed 4/1/26 | Tue 4/7/26 | 4,5 | Роман
33 | 1.2.4.2 | Определить набор типовых элементов | 7 days | Wed 4/8/26 | Thu 4/16/26 | 32 | Роман
34 | 1.2.4.3 | Подготовить композитную матрицу | 7 days | Mon 5/18/26 | Fri 6/19/26 | 33,12,44 | Данил
35 | 1.2.5 | Прочностные расчеты | 15.5 days | Sat 4/25/26 | Tue 5/19/26
36 | 1.2.5.1 | Оценка эксплуатационных и предельных перегрузок | 3 days | Wed 4/22/26 | Fri 4/24/26 | 4,19 | Дмитрий
37 | 1.2.5.2 | V-n диаграмма | 6 days | Wed 4/29/26 | Thu 5/7/26 | 36 | Данил
38 | 1.2.5.3 | Центровочная ведомость | 6 days | Fri 5/8/26 | Mon 5/18/26 | 17,31 | Дмитрий
39 | 1.2.6 | Компьютерное зрение | 5 wks | Wed 3/25/26 | Tue 4/28/26
40 | 1.2.6.1 | Создать базу сжатых изображений символов | 5 days | Wed 3/25/26 | Tue 3/31/26 | | Роман
41 | 1.2.6.2 | Работа с записью данных на SD5 days | | Mon 3/30/26 | Fri 4/3/26 | | Роман
42 | 1.2.6.3 | Алгоритмы анализа и обработки изображений | 3 wks | Wed 3/25/26 | Tue 4/14/26 | | Роман
43 | 1.2.6.4 | Прием и обработка данных по UART | 5 days | Wed 4/15/26 | Tue 4/21/26 | | Роман
44 | 1.2.7 | Детализированная 3D модель | 21 days | Thu 4/30/26 | Thu 6/25/26
45 | 1.2.8 | Система контроля груза | 25 days | Thu 4/2/26 | Thu 5/7/26
46 | 1.2.8.1 | Баллистический калькулятор | 2 wks | Thu 4/2/26 | Wed 4/15/26 | 4,6,7 | Дмитрий
47 | 1.2.8.2 | Разработка и проектирование конструкции сброса | 3 wks | Thu 4/16/26 | Thu 5/7/26 | 12,46 | Дмитрий
48 | 1.2.8.3 | Проектирование и расчет динамики груза | | | | | Дмитрий
49 | 1.3 | Производство | 23 days | Fri 5/15/26 | Fri 7/10/26
50 | 1.3.1 | Изготовление фюзеляжа | 3 wks | Fri 5/15/26 | Tue 6/30/26 | 12,31,44 | Данил
51 | 1.3.2 | Резка крыла | 2 wks | Tue 5/5/26 | Tue 5/19/26 | 12,31 | Данил
52 | 1.3.3 | Изготовление хвостового оперения | 2 wks | Fri 5/15/26 | Tue 6/23/26 | 12,31 | Данил
53 | 1.3.4 | Макетирования работы бортового оборудования | 2 wks | Thu 5/14/26 | Mon 6/22/26 | 22,39 | Марина,Дмитрий
54 | 1.3.5 | Проектирование транспортировочной коробки | 1 wk | Wed 7/1/26 | Tue 7/7/26 | 44,50,51 | Роман
55 | 1.3.6 | Натурные испытания на прочность элементов | 15 days | Mon 6/15/26 | Fri 7/3/26 | 34,36 | Дмитрий
56 | 1.3.7 | Тренировка в симуляторе | 0 days | Fri 7/10/26 | Fri 7/10/26 | | Дмитрий,Марина
57 | 1.4 | Испытания | 0 days | Wed 7/15/26 | Wed 7/15/26 | | *

Роман

Роман

Роман

T | W | T | F | S | S | M | T | W | T | F | S | S | M | T | W | T | F | S | S | M | T | W | T | F | S | S | M | T | W | T | F | S
Mar 15, '26 | Mar 22, '26 | Mar 29, '26 | Apr 5, '26

Task
Split
Milestone

Project Summary
Inactive Task
Inactive Milestone

Manual Task
Duration-only
Manual Summary Rollup

Start-only
Finish-only
External Tasks

Deadline
Progress
Manual Progress

Page 2

Project: Project1
Date: Fri 5/15/26

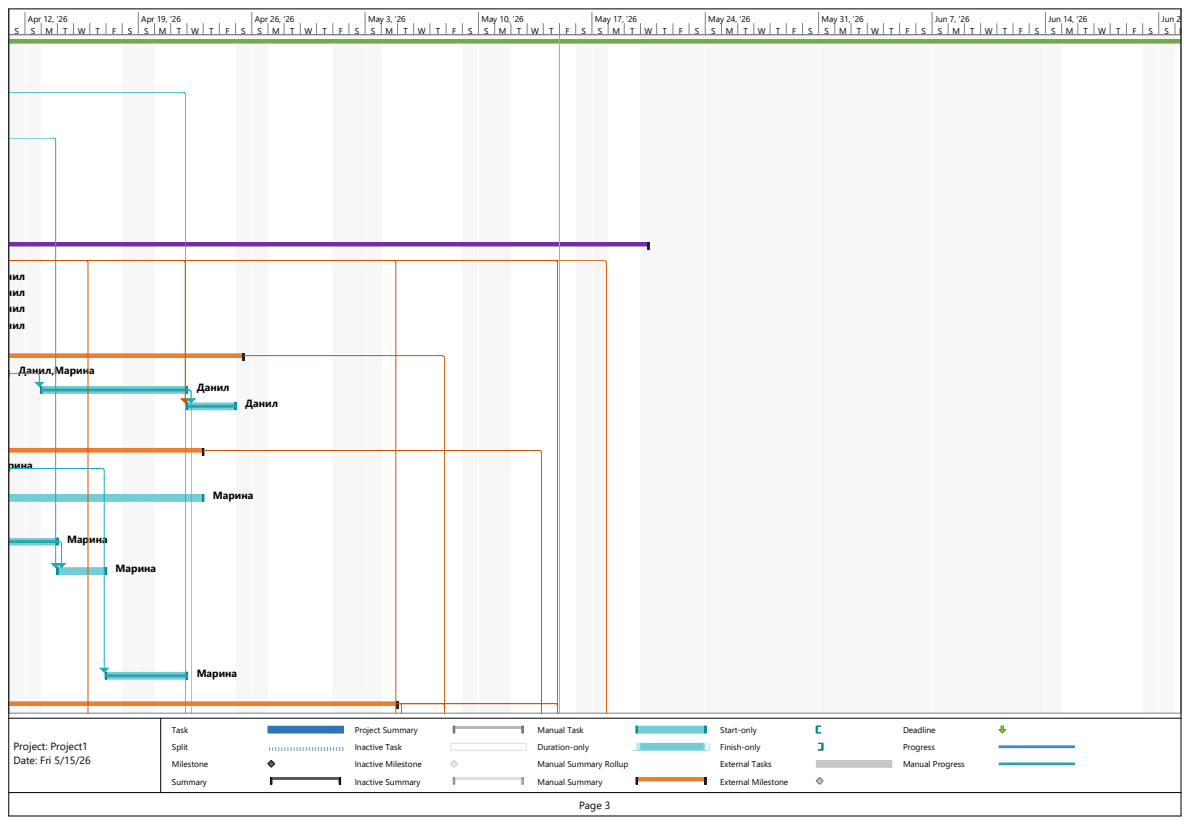
[picture p101: page 3]
Данил,Марина; Данил; Марина; Apr 12, '26; Apr 19, '26; Apr 26, '26; May 3, '26; May 10, '26; May 17, '26; May 24, '26; May 31, '26; Jun 7, '26; Jun 14, '26; Jun 21, '26; Task; Split; Milestone; Project Summary; Inactive Task; Inactive Milestone; Start-only; Finish-only; External Tasks; Deadline; Progress; Manual Progress; Page 3; Project: Project1 Date: Fri 5/15/26

Manual Task
Duration-only
Manual Summary Rollup

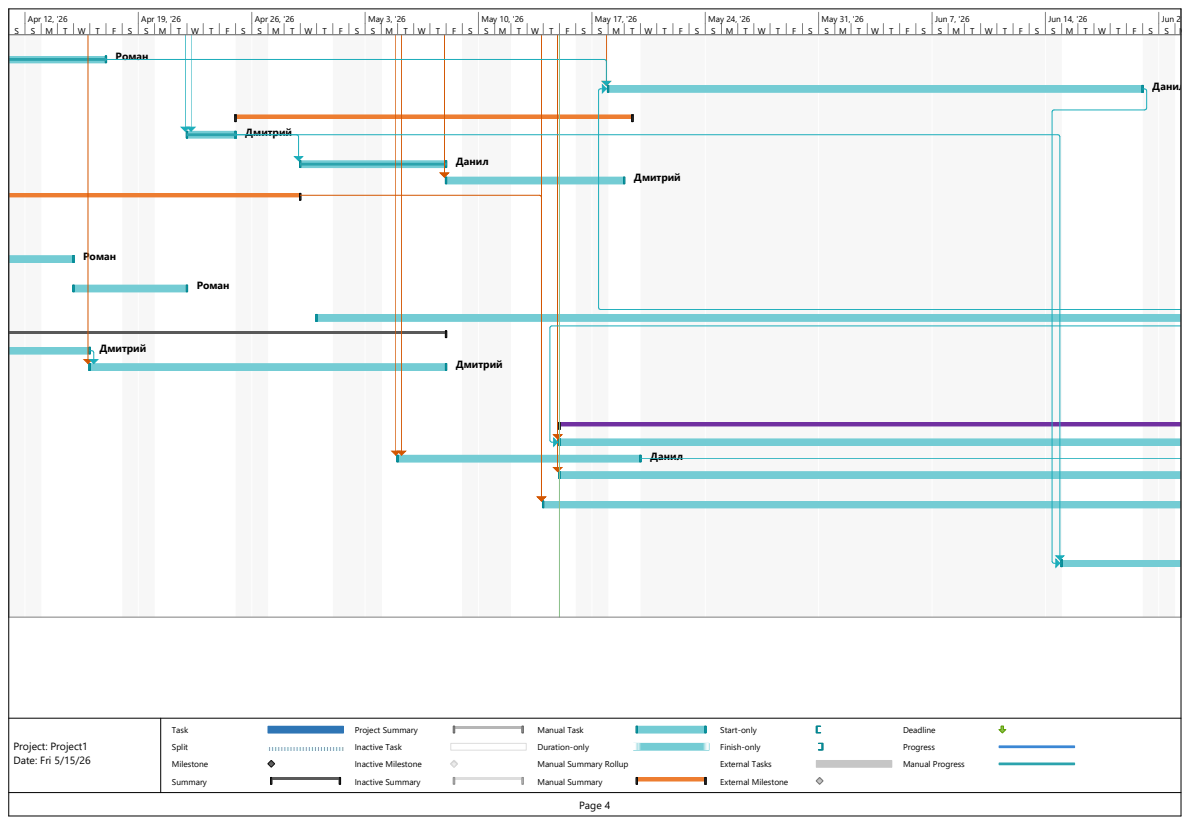
[picture p102: page 4]
Роман; Данил; Дмитрий; Apr 12, '26; Apr 19, '26; Apr 26, '26; May 3, '26; May 10, '26; May 17, '26; May 24, '26; May 31, '26; Jun 7, '26; Jun 14, '26; Jun 21, '26; Task; Split; Milestone; Project Summary; Inactive Task; Inactive Milestone; Start-only; Finish-only; External Tasks; Deadline; Progress; Manual Progress; Page 4; Project: Project1 Date: Fri 5/15/26

Manual Task
Duration-only
Manual Summary Rollup

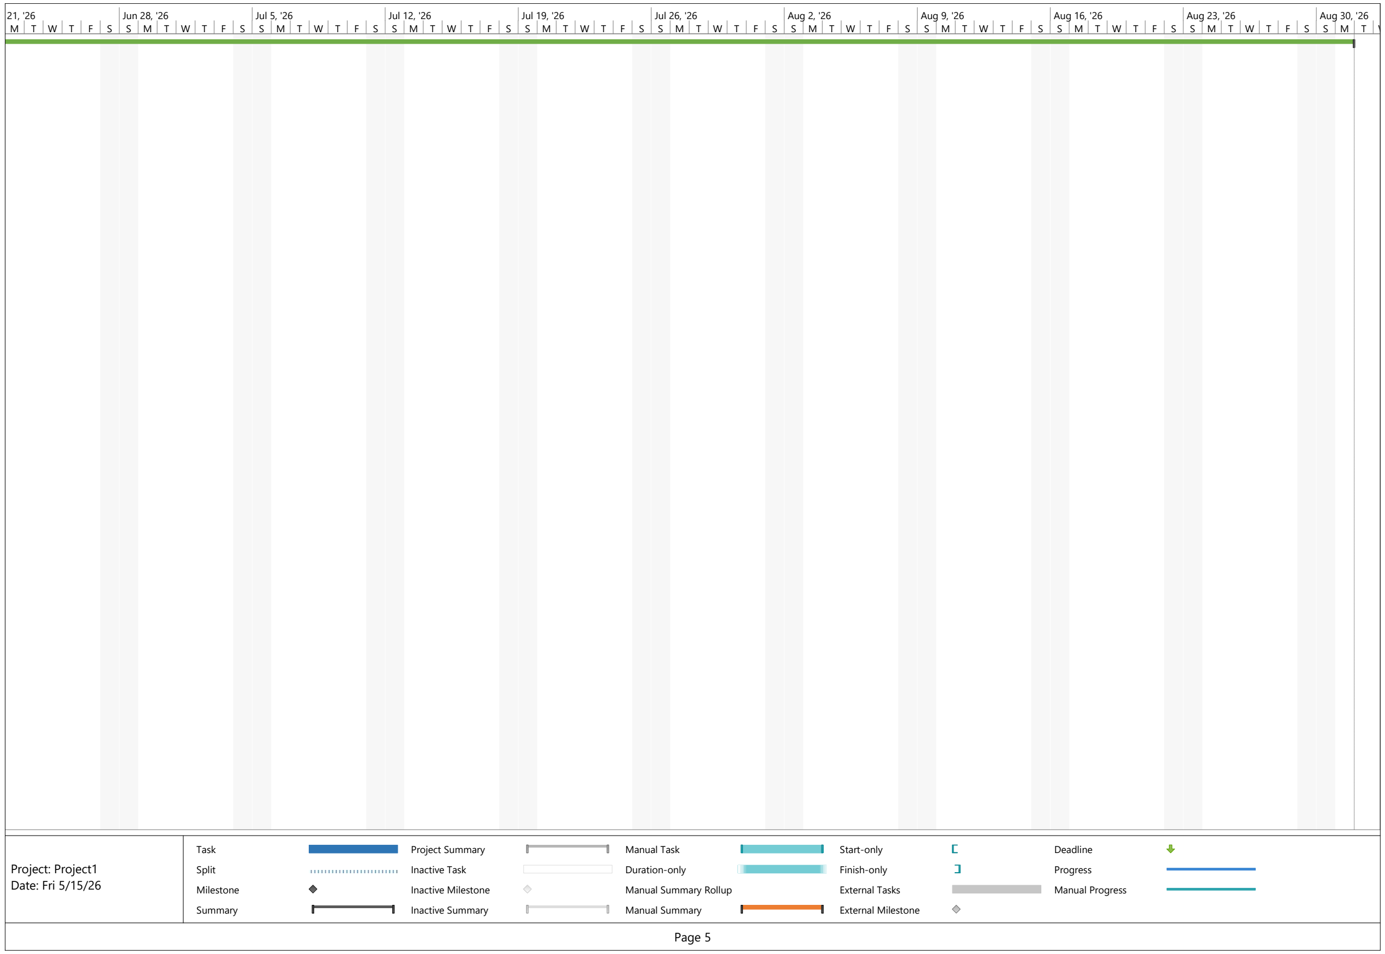
[picture p103: figure]
Jun 28, '26; Jul 5, '26; Jul 12, '26; Jul 19, '26; Jul 26, '26; Aug 2, '26; Aug 9, '26; Aug 16, '26; Aug 23, '26; Aug 30, '26; Task; Split; Milestone; Project Summary; Inactive Task; Inactive Milestone; Manual Task; Duration-only; Manual Summary Rollup; Start-only; Finish-only; External Tasks; Deadline; Progress; Manual Progress; Page 5; Project: Project1 Date: Fri 5/15/26

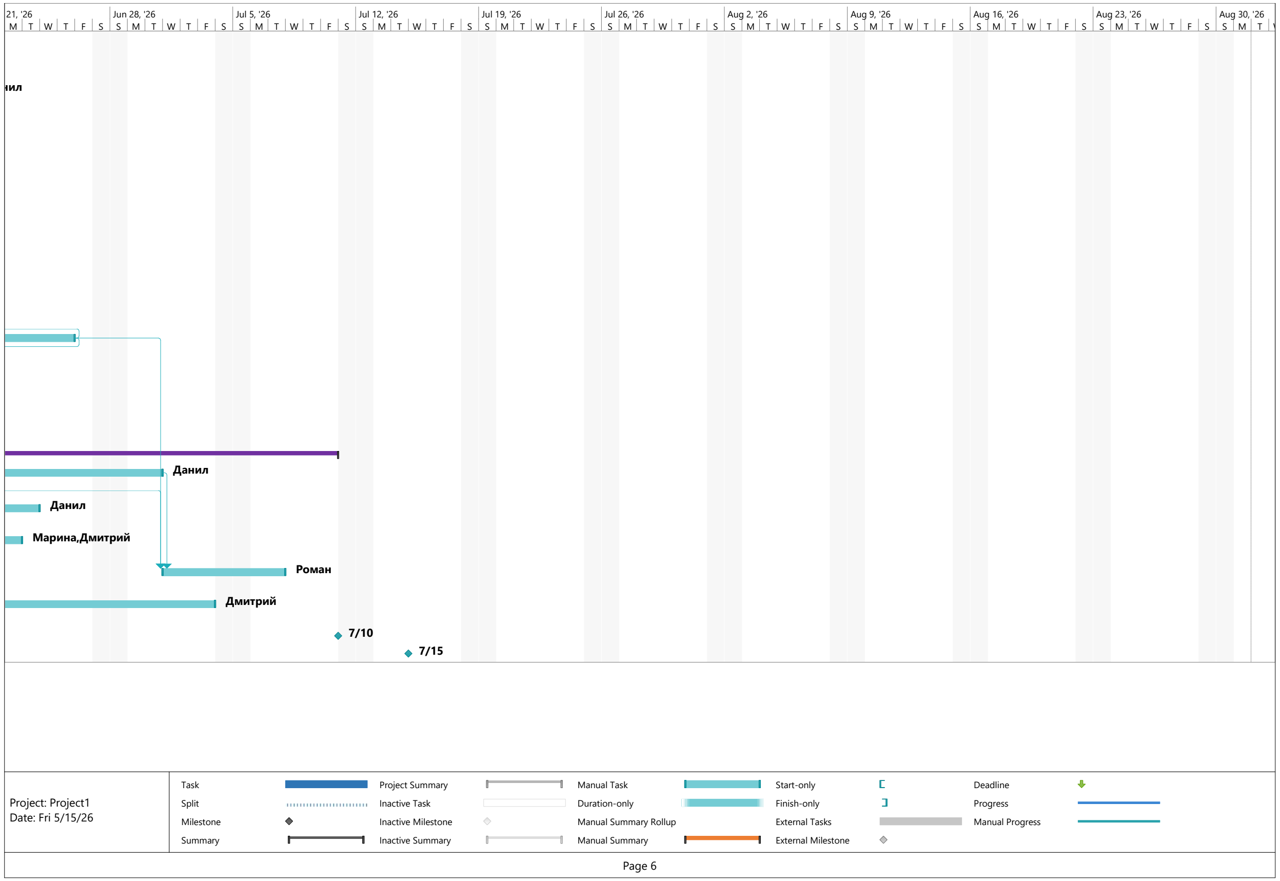
[picture p104: figure]
Данил; Марина,Дмитрий; Роман; Дмитрий; Jun 28, '26; Jul 5, '26; Jul 12, '26; Jul 19, '26; Jul 26, '26; Aug 2, '26; Aug 9, '26; Aug 16, '26; Aug 23, '26; Aug 30, '26; Task; Split; Milestone; Project Summary; Inactive Task; Inactive Milestone; Manual Task; Duration-only; Manual Summary Rollup; Start-only; Finish-only; External Tasks; Deadline; Progress; Manual Progress; Page 6; Project: Project1 Date: Fri 5/15/26
