Suturin-Daniil/Shchegly_SKAT26/(commit log)

2026-03-10 Added directory with detailed 3d model
    [Cargo.SLDPRT, ESC.SLDPRT, Horn.SLDPRT, JXServo.SLDPRT, Tracker.SLDPRT]
2026-03-15 Переименовал папки
    [Cargo.SLDPRT, ESC.SLDPRT, Horn.SLDPRT, JXServo.SLDPRT, Tracker.SLDPRT]
2026-03-15 Убрал названия латиницей
    [Cargo.SLDPRT, ESC.SLDPRT, Horn.SLDPRT, JXServo.SLDPRT, Tracker.SLDPRT]
2026-03-15 Добавил папку с бортовым оборудованием
2026-03-15 Добавил документацию на Matek H743-Wing
2026-03-15 Добавил авиационные правила для V-n диаграммы, соотвествие ГОСТ и ISO
2026-03-15 Добавил папку со сметой
    [Смета.xlsx]
2026-03-18 Добавил сравнительную таблицу энергопотребления моторов
2026-03-19 Добавил документацию на USB-TTL адаптер
2026-03-24 рассмотрел несколько винтов 10х70, сравнил 3 конфигурации су, привел график зависимости располагаемой тяги от скорости полета
2026-03-27 Добавил исправленную версию графика работ
2026-03-28 Добавлен датасет и скрипт обработки
2026-03-29 3D модель OpenMV
2026-03-31 Добавил модель груза, мотора + анимация обтекания груза при 18 м/с
    [Cargo.SLDPRT, Fuselage.SLDPRT, Tracker.SLDPRT, X2814.SLDPRT]
2026-03-31 Добавил комментрии к функциям
2026-04-03 Структурировал папки. Добавил ГОСТы
    [1000minds-ahp-example-tables.xlsx]
2026-04-03 Акуальная версия графика работ
2026-04-14 Добавил несколько новых функций в код. Для подсчеа распределенных коэффициентов вдоль размаха и коэффициента момента тангажа
2026-04-14 Добавил документацию на Xfoil
    [1000minds-ahp-example-tables.xlsx, WingForm.xlsx]
2026-04-14 Добавил модель модуля телеметрии
    [TelemetryModule.STEP]
2026-04-15 Добавил позиции в смету, которые закупили; а также чеки из магазинов
    [Смета.xlsx]
2026-04-17 Добавил модель полетного контроллера
    [CAP 1 uF 0603.step.SLDPRT, CAP 22 uF 0805.step.SLDPRT, CAP 2pt2 uF 0603.step.SLDPRT, CAP pt1 uF 0603.step.SLDPRT, Cap 12pf 0603.step.SLDPRT, EXBV8V 10k.step.SLDPRT, FCBoard1.SLDPRT, FCBoard2.SLDPRT]
2026-04-17 Добавил модели датчиков: ПВД, GPS, трекер
    [ASPD-4525.step, ASPD-4525.step.SLDPRT, GNSS Matek M10q 5883.stp, Tracker.SLDPRT, ВидеоПередатчик.SLDPRT]
2026-04-19 Изменения в отчете
2026-04-28 Внес в код подсчет нормальной силы винта
2026-04-28 Убрал лишние модели smd компонетов
    [ASPD-4525.SLDPRT, CAP 1 uF 0603.step.SLDPRT, CAP 22 uF 0805.step.SLDPRT, CAP 2pt2 uF 0603.step.SLDPRT, CAP pt1 uF 0603.step.SLDPRT, Cap 12pf 0603.step.SLDPRT, EXBV8V 10k.step.SLDPRT, IND 3.9nh 0603.step.SLDPRT]
2026-05-01 Добавлена OpenMV в смету
    [Смета.xlsx]
2026-05-01 Добавил конфигурацию с профилем SG6043
2026-05-01 Почистил папку
    [Cargo.SLDPRT, GNSS Matek M10q 5883.stp.SLDPRT, TelemetryModule.STEP, payload.step]
2026-05-04 Добавил файл проектного отчета
2026-05-06 Добавил программу для работы с профилями
2026-05-11 Добавил балансировочню кривую
2026-05-11 Дополнил отчет проектный
    [Эскиз.SLDDRW]
2026-05-13 Добавил таблицу с потреблением мотора
2026-05-13 Форматирование
2026-05-14 Обновление отчета
2026-05-15 V-n диаграмма
2026-05-15 Исправил график работ
2026-05-15 Добавил модель
2026-05-15 Закончен проектный отчет
